scramble-robot/rcj-2022/Vison-raspi/cam-test/image/1.jpg

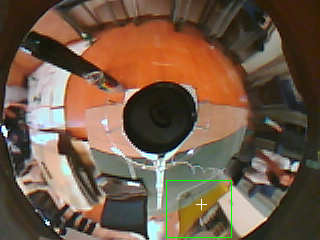
Vison-raspi/cam-test/image/1.jpg
