scramble-robot/rcj-2022/Vison-raspi/cam-test/image/2.jpg

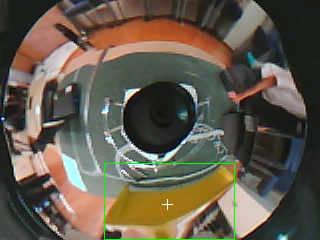
Vison-raspi/cam-test/image/2.jpg
