scramble-robot/rcj-2022/README.md

# rcj-2022

This program made by scramble rcj team.
