scramble-robot/rcj-2022/kicad/main-lg/main20220103/main20220103.dxf

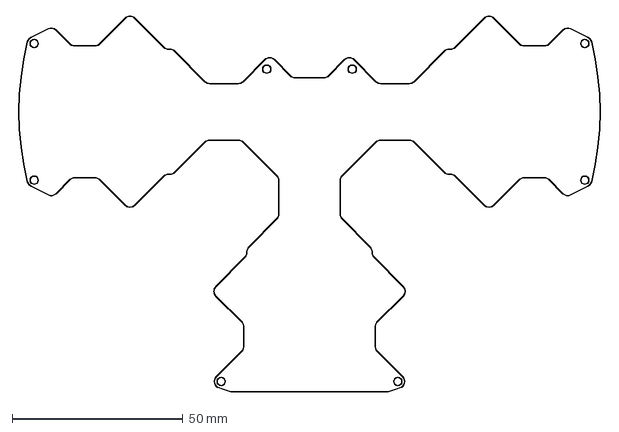
[picture p3: CAD file, 2022-02-06]
kicad/main-lg/main20220103/main20220103.dxf
171.7 x 109.9 mm
