scramble-robot/rcj-2022/kicad/kick-drib-2/control-2021-2.dxf

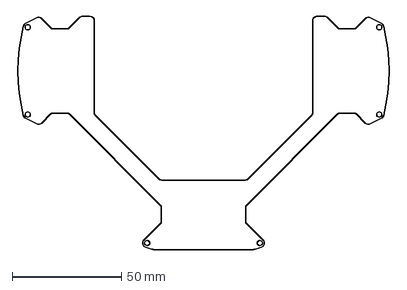
[picture p4: CAD file, 2022-02-06]
kicad/kick-drib-2/control-2021-2.dxf
171.7 x 106.9 mm
