scramble-robot/rcj-2022/kicad/line_senser20220225/line_senser20220224.step

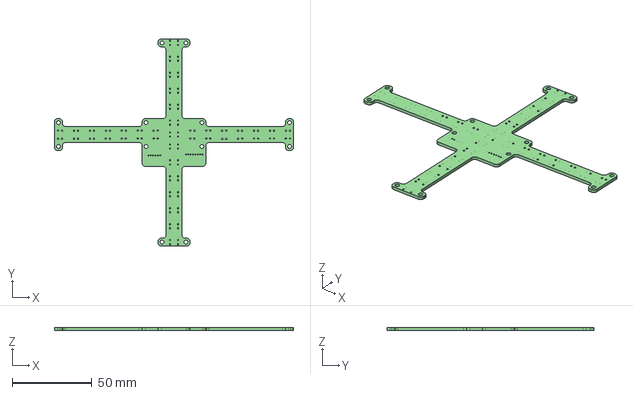
[picture p5: CAD file, 2022-02-26]
kicad/line_senser20220225/line_senser20220224.step
150.0 x 130.0 x 1.60 mm
