scramble-robot/rcj-2022/kicad/xbee-gyro20220207/xbee-gyro20220207.dxf

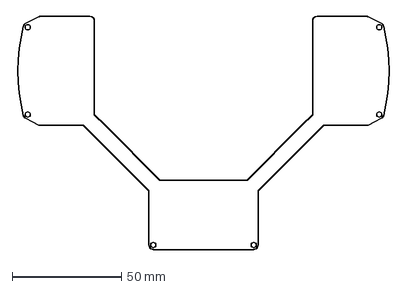
[picture p6: CAD file, 2022-02-06]
kicad/xbee-gyro20220207/xbee-gyro20220207.dxf
171.7 x 106.9 mm
