scramble-robot/rcj-2022/kicad/line_senser20220225/LINE!.dxf

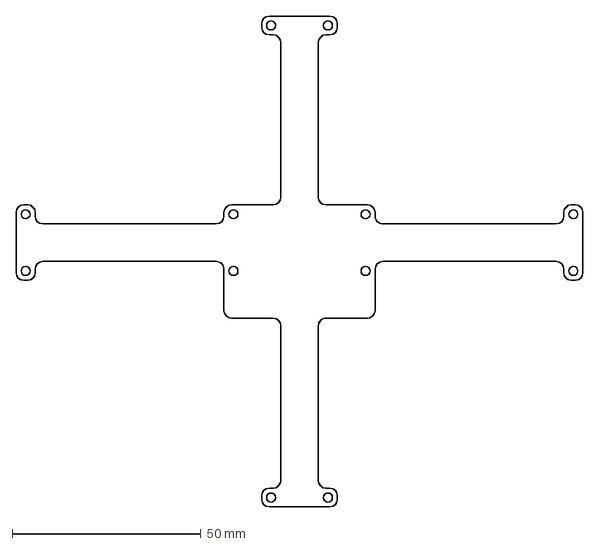
[picture p7: CAD file, 2022-02-26]
kicad/line_senser20220225/LINE!.dxf
150.0 x 130.0 mm
