scramble-robot/rcj-2022/kicad/line_senser20220225/line_senser20220225.step

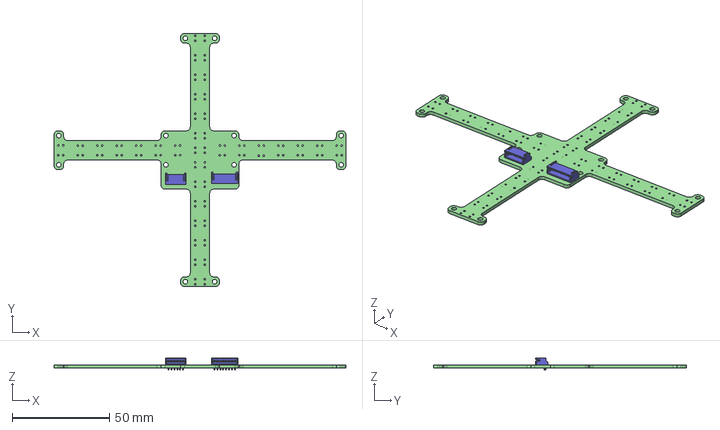
[picture p8: CAD file, 2022-02-26]
kicad/line_senser20220225/line_senser20220225.step
150.0 x 130.0 x 6.40 mm
line_senser20220224 PCB
