scramble-robot/rcj-2022/(list of files, cad)

Other CAD files:
kicad/line_senser20220225/line.dxf
kicad/line_senser20220225/line_senser20220225.dxf
