scramble-robot/rcj-2022/Vison-raspi/cam-test/colortracking-test/9.bmp

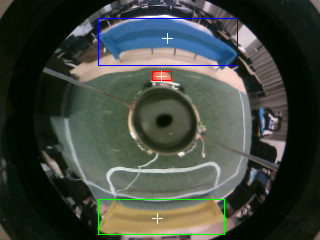
Vison-raspi/cam-test/colortracking-test/9.bmp
