scramble-robot/rcj-2022/Vison-raspi/cam-test/result.jpg

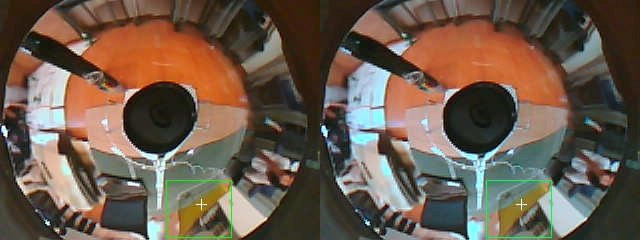
Vison-raspi/cam-test/result.jpg
