scramble-robot/rcj-2022/(list of files, drawings)

Other design files:
kicad/IMU_BNO055_20210802/IMU_BNO055_20210802.dsn
kicad/kick-drib-2/kick-drib-2.dsn
kicad/kick-drib/kick-drib.dsn
kicad/line_senser20220225/line_senser20220225.dsn
kicad/main20220221/main20220221.dsn
kicad/main-lg/main20220103/main20220103.dsn
kicad/main-lg/main20220212-2/main20220103-2.dsn
kicad/main-lg/main20220212-3/main20220212-3.dsn
kicad/main-lg/main20220213 - コピー/main20220213.dsn
kicad/main-lg/main20220213/main20220213.dsn
kicad/main-lg/main20220215/main20220215.dsn
kicad/main-lg/main20220217/main20220217.dsn
kicad/xbee-gyro20220207/xbee-gyro20220207.dsn
