scramble-robot/rcj-2022/kicad/xbee-gyro20220207/xbee-gyro20220207.kicad_pcb

## KiCad design kicad/xbee-gyro20220207/xbee-gyro20220207.kicad_pcb (2022-04-21)

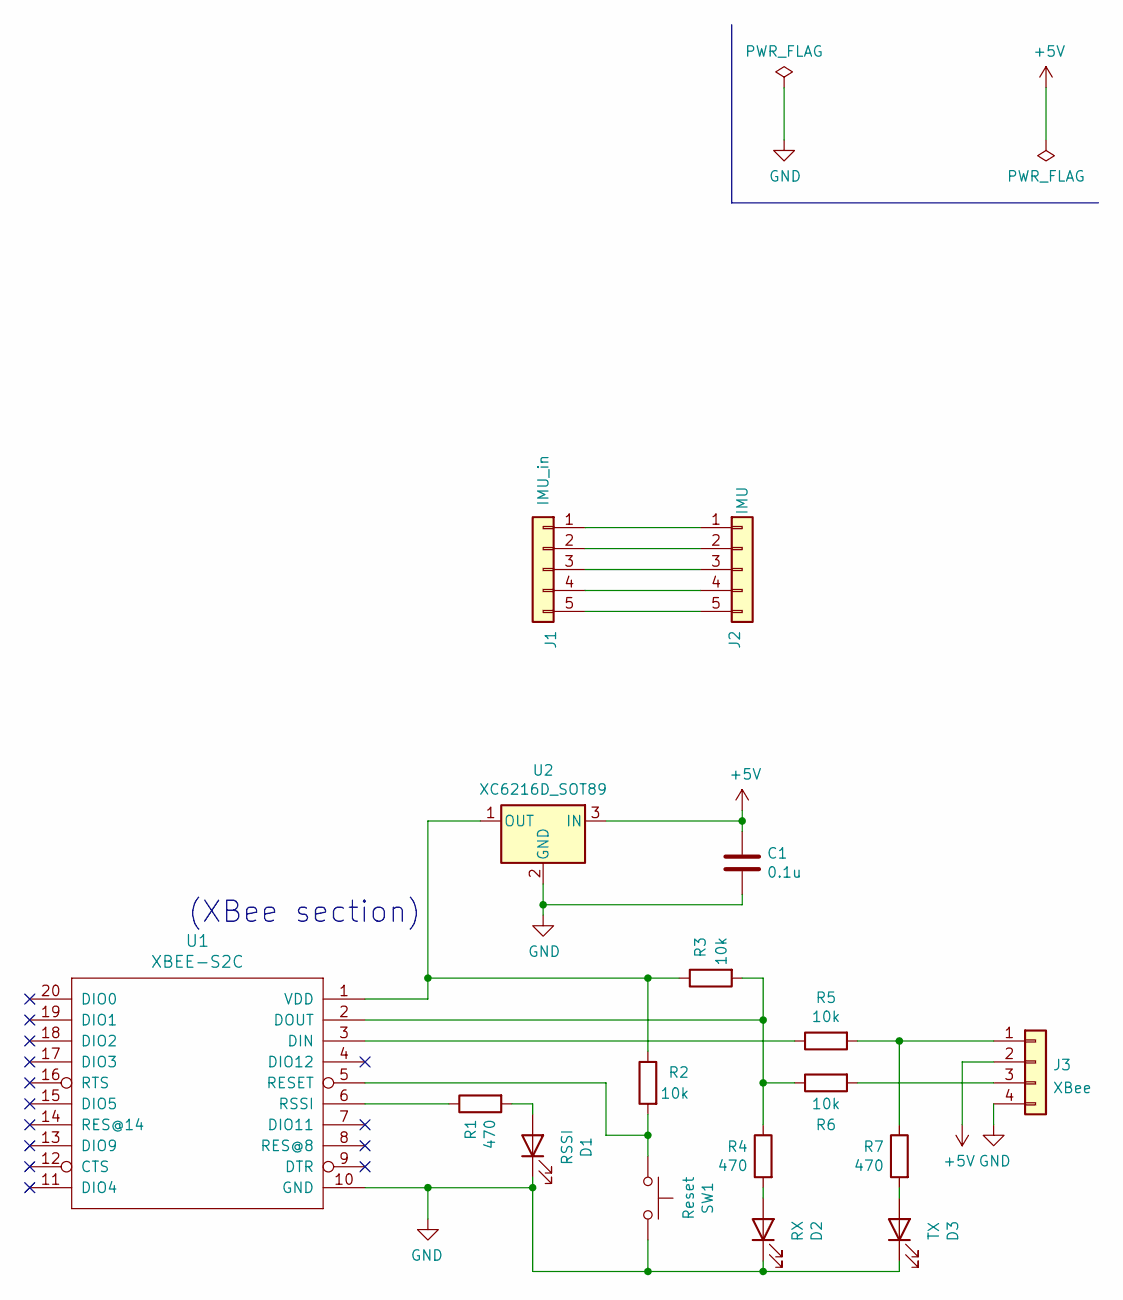
[picture p11: schematic xbee-gyro20220207.kicad_sch, control board]

Parts:
C1: 0.1u; C_0603_1608Metric_Pad1.08x0.95mm_HandSolder
D1: RSSI; LED_0603_1608Metric_Pad1.05x0.95mm_HandSolder
D2: RX; LED_0603_1608Metric_Pad1.05x0.95mm_HandSolder
D3: TX; LED_0603_1608Metric_Pad1.05x0.95mm_HandSolder
J1: IMU_in; PinHeader_1x05_P1.27mm_Vertical
J2: IMU; PinSocket_1x05_P2.54mm_Vertical
J3: XBee; PinSocket_1x04_P2.54mm_Vertical
R1, R4, R7: 470; R_0603_1608Metric_Pad0.98x0.95mm_HandSolder
R2, R3, R5, R6: 10k; R_0603_1608Metric_Pad0.98x0.95mm_HandSolder
SW1: Reset; THAU13-AB-R
U1: XBEE-S2C
U2: XC6216D_SOT89; SOT-89-3

Connections:
+5V: C1.1, J3.2, U2.3 (IN)
GND: C1.2, D1.1 (K), D2.1 (K), D3.1 (K), J3.4, SW1.2, U1.10 (GND), U2.2 (GND)
unnamed: D1.2 (A), R1.2
unnamed: D2.2 (A), R4.2
unnamed: D3.2 (A), R7.2
unnamed: J1.1, J2.1
unnamed: J1.2, J2.2
unnamed: J1.3, J2.3
unnamed: J1.4, J2.4
unnamed: J1.5, J2.5
unnamed: J3.1, R5.2, R7.1
unnamed: J3.3, R6.2
unnamed: R1.1, U1.6 (RSSI)
unnamed: R2.1, R3.1, U1.1 (VDD), U2.1 (OUT)
unnamed: R2.2, SW1.1, U1.5 (RESET)
unnamed: R3.2, R4.1, R6.1, U1.2 (DOUT)
unnamed: R5.1, U1.3 (DIN)

Notes on the sheet:
(XBee section)

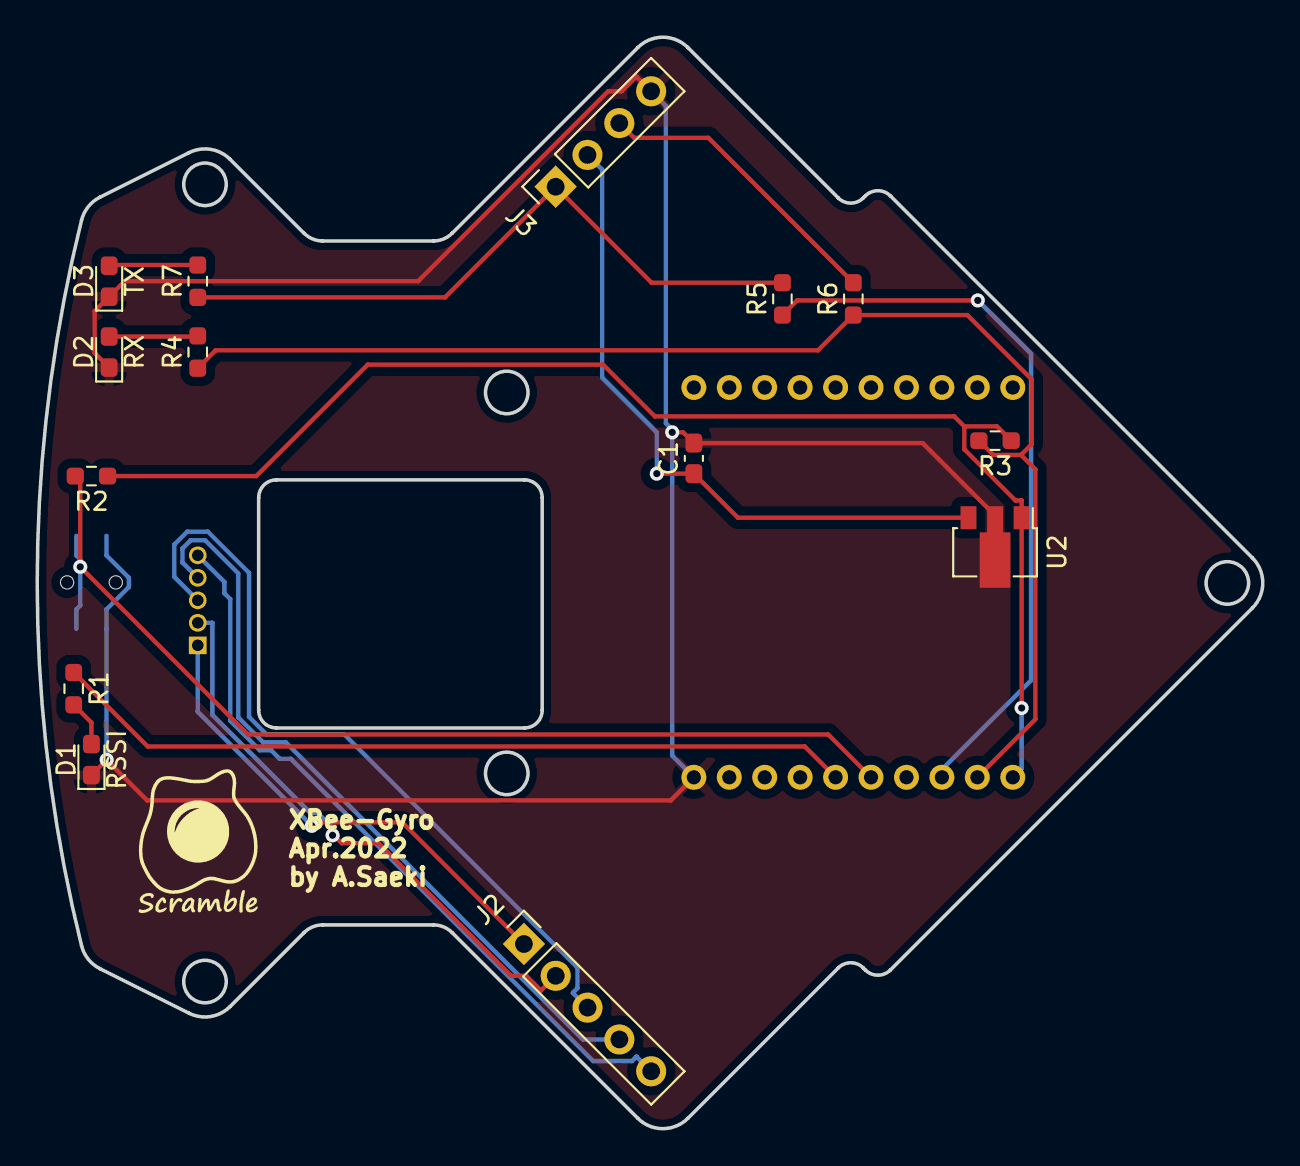
[picture p12: board xbee-gyro20220207.kicad_pcb from above]

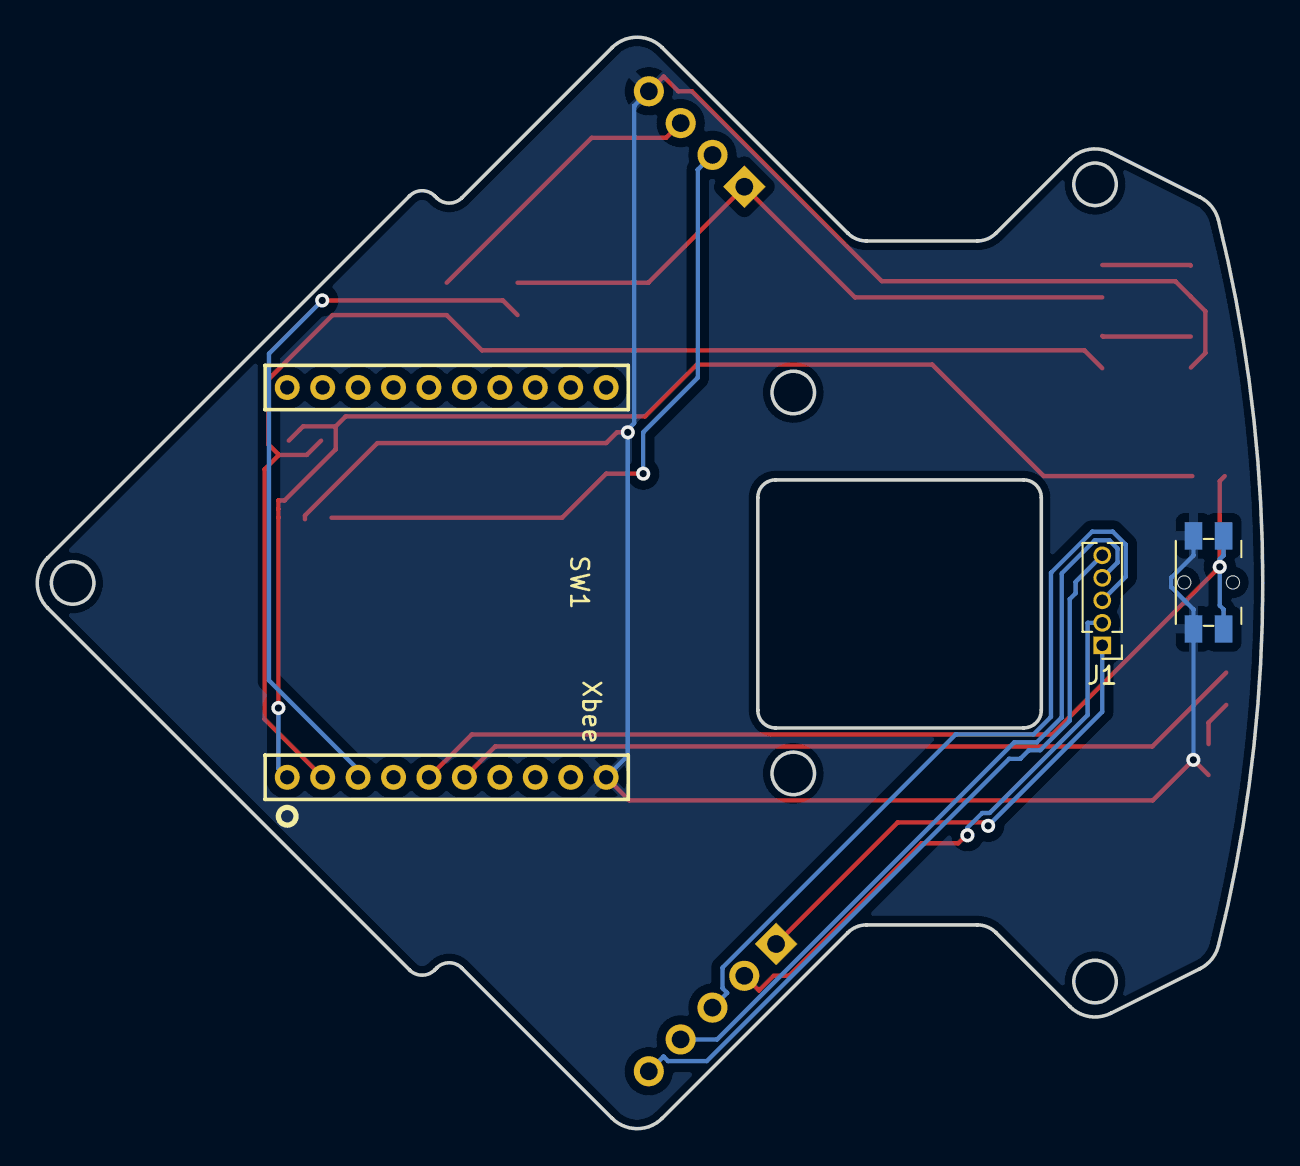
[picture p13: board xbee-gyro20220207.kicad_pcb from below]

Board: 2 copper layers, 69.2 x 61.6 mm, 17 parts (3 on the bottom side), 17 nets.
