scramble-robot/rcj-2022/kicad/main-lg/main20220217/main20220217.kicad_pcb

## KiCad design kicad/main-lg/main20220217/main20220217.kicad_pcb (2022-02-26)

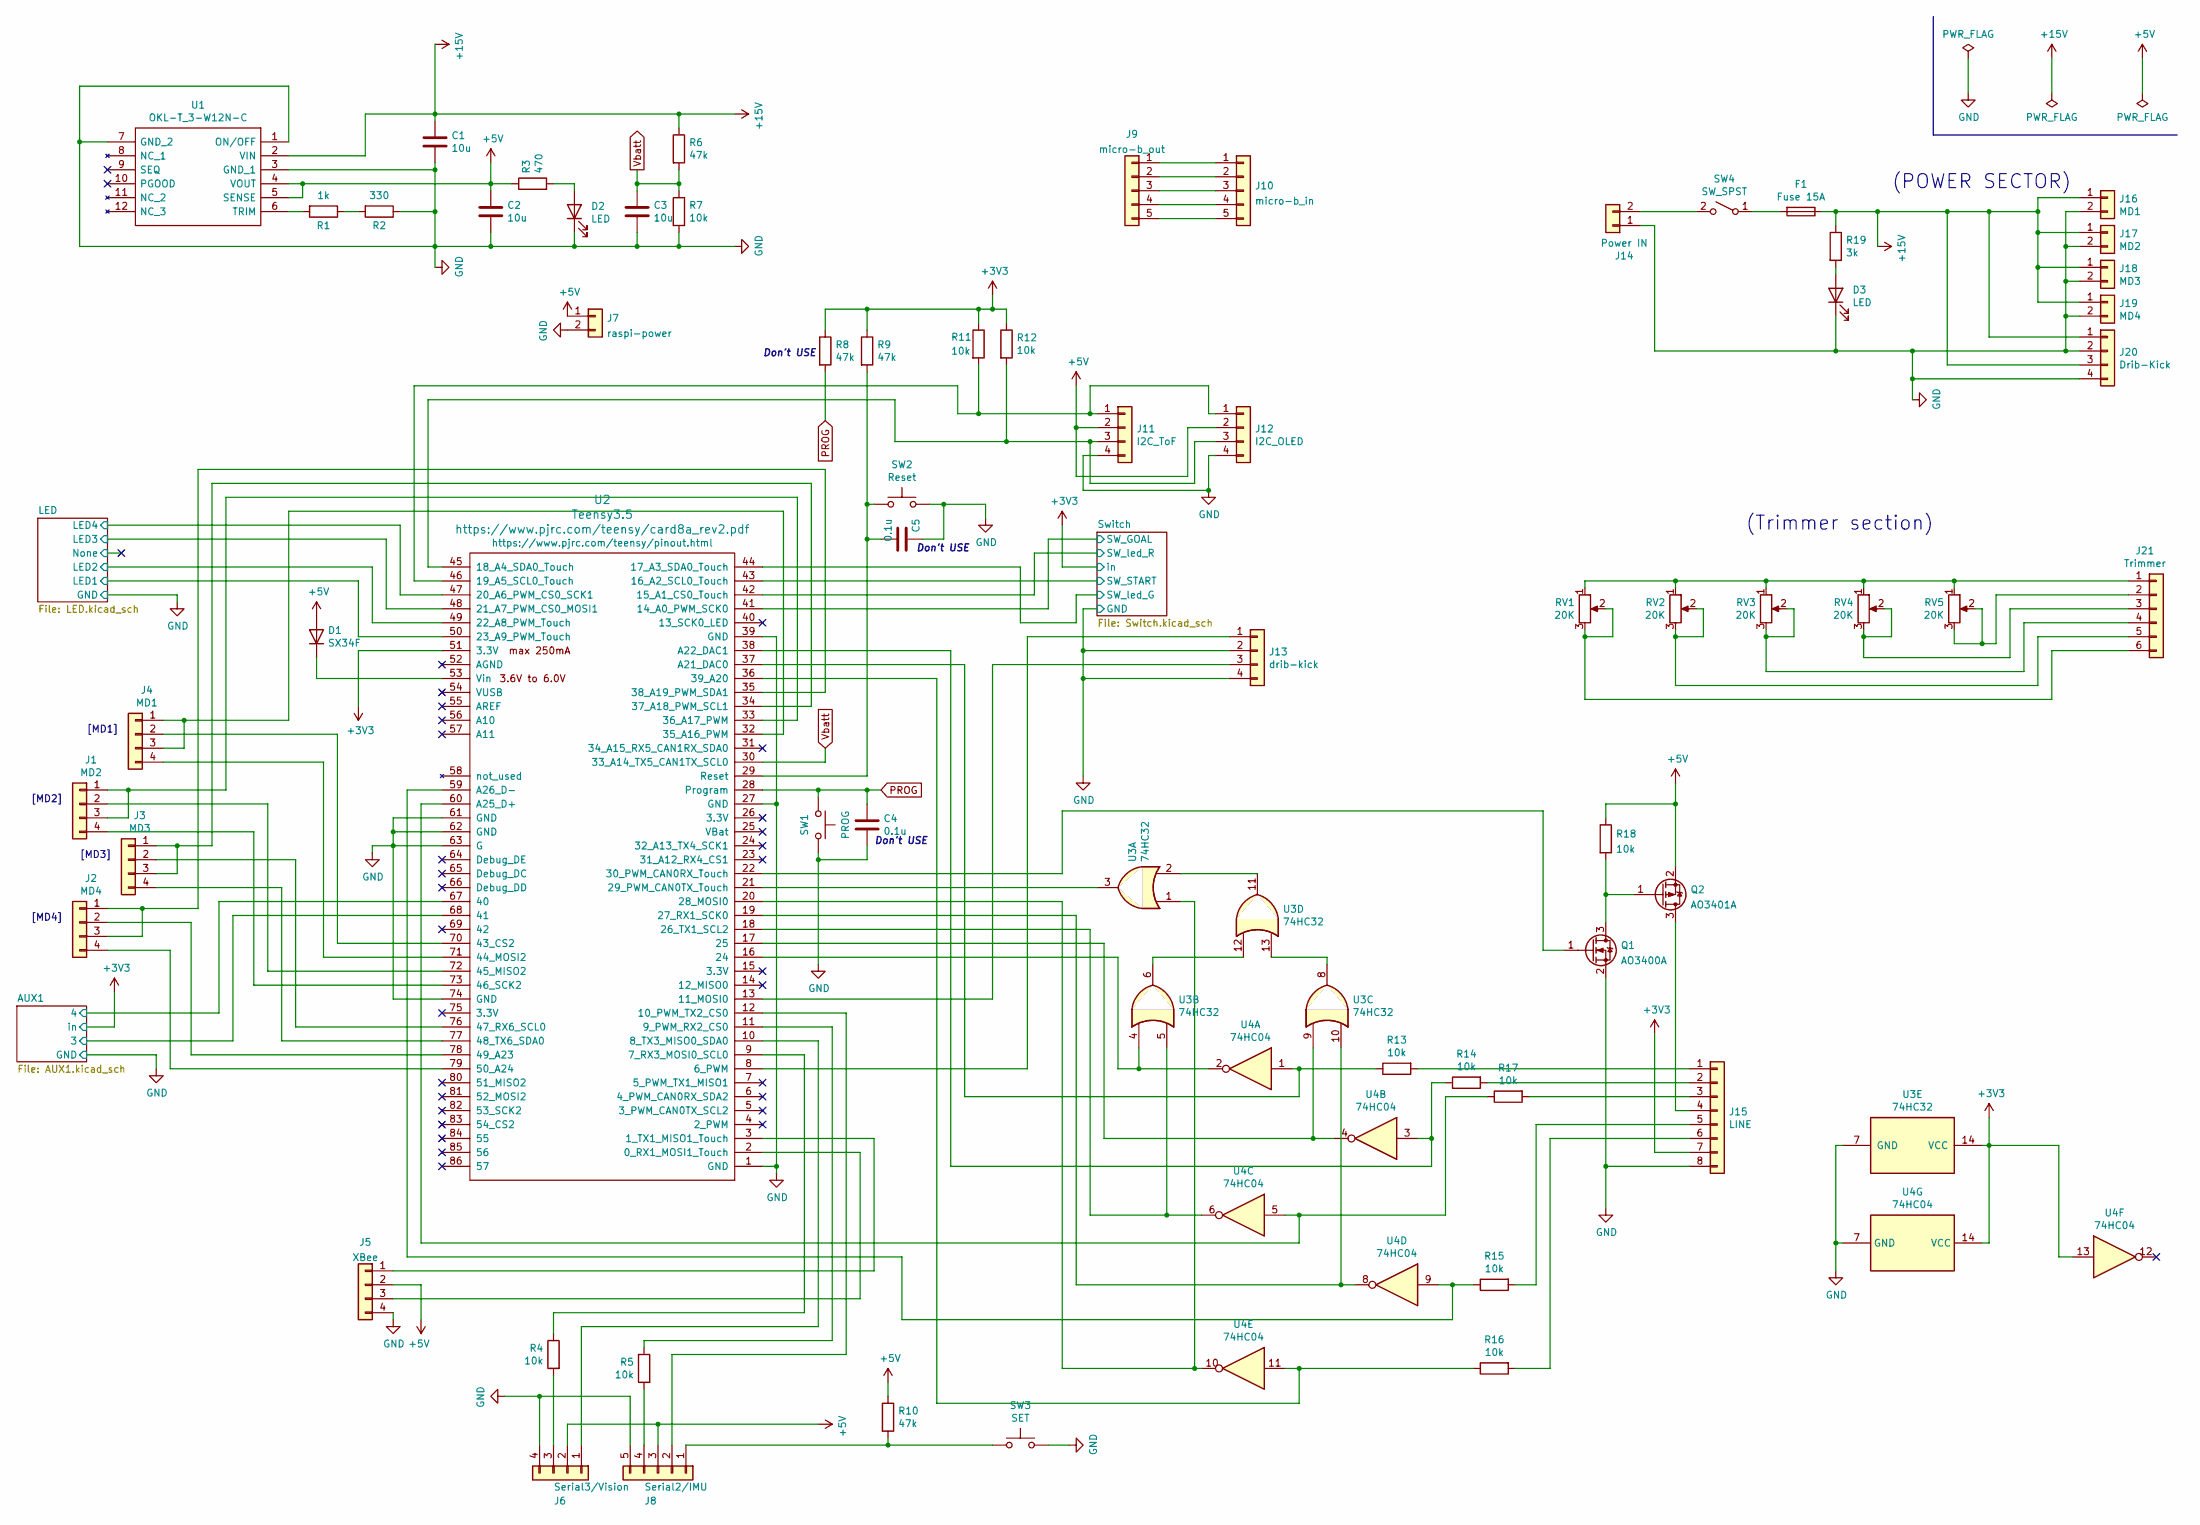
[picture p14: schematic main20220217.kicad_sch, main board]

Parts:
C1, C2, C3: 10u; C_0603_1608Metric_Pad1.08x0.95mm_HandSolder
C4, C5: 0.1u; C_0603_1608Metric_Pad1.08x0.95mm_HandSolder
D1: SX34F; D_SMA
D2, D3: LED; LED_SMLE13WBC8W1
F1: Fuse 15A; FUSE_20mm
J1: MD2; JSTS4B-ZRLFSN
J2: MD4; JSTS4B-ZRLFSN
J3: MD3; JSTS4B-ZRLFSN
J4: MD1; JSTS4B-ZRLFSN
J5: XBee; PinSocket_1x04_P2.54mm_Vertical
J6: Serial3/Vision; JSTB4B-ZR
J7: raspi-power; JST_PH_B2B-PH-K_1x02_P2.00mm_Vertical
J8: Serial2/IMU; PinSocket_1x05_P2.54mm_Vertical
J9: micro-b_out; PinHeader_1x05_P2.54mm_Vertical
J10: micro-b_in; PinHeader_1x05_P2.54mm_Vertical
J11: I2C_ToF; JSTS4B-ZRLFSN
J12: I2C_OLED; OLED
J13: drib-kick; PinSocket_1x04_P2.54mm_Vertical
J14: Power IN; AMASS_XT60-M_1x02_P7.20mm_Vertical
J15: LINE; JSTS8B-ZRLFSN
J16: MD1; JST_XH_B2B-XH-A_1x02_P2.50mm_Vertical
J17: MD2; JST_XH_B2B-XH-A_1x02_P2.50mm_Vertical
J18: MD3; JST_XH_B2B-XH-A_1x02_P2.50mm_Vertical
J19: MD4; JST_XH_B2B-XH-A_1x02_P2.50mm_Vertical
J20: Drib-Kick; PinSocket_1x04_P2.54mm_Vertical
J21: Trimmer; JSTS6B-ZRLFSN
Q1: AO3400A; SOT-23
Q2: AO3401A; SOT-23
R1: 1k; R_Axial_DIN0204_L3.6mm_D1.6mm_P5.08mm_Horizontal
R2: 330; R_Axial_DIN0204_L3.6mm_D1.6mm_P5.08mm_Horizontal
R3: 470; R_0603_1608Metric_Pad0.98x0.95mm_HandSolder
R4, R5, R7, R11, R12, R13, R14, R15, R16, R17, R18: 10k; R_0603_1608Metric_Pad0.98x0.95mm_HandSolder
R6, R8, R9, R10: 47k; R_0603_1608Metric_Pad0.98x0.95mm_HandSolder
R19: 3k; R_0603_1608Metric_Pad0.98x0.95mm_HandSolder
RV1, RV2, RV3, RV4, RV5: 20K; Trim-GF063P
SW1: PROG; TVAF06-A020B-R
SW2: Reset; THAU13-AB-R
SW3: SET; SW_PUSH_6mm
SW4: SW_SPST; SW_SPST_POWER
U1: OKL-T_3-W12N-C; OKL-T3-W12N-C; Manufacturer_Part_Number OKL-T/6-W12N-C; Mouser Part Number 580-OKL-T/6-W12N-C
U2: Teensy3.5; Teensy35_36_x
U3: 74HC32; SOP14W
U4: 74HC04; SOP14W

Connections:
+3V3: J15.7, R8.1, R9.1, R11.1, R12.1, U2.51 (3.3V), U3.14 (VCC), U4.13, U4.14 (VCC); also elsewhere on the board
+5V: C2.1, D1.2 (A), J5.2, J6.2, J7.1, J8.3, J11.2, J12.2, Q2.2 (S), R3.1, R10.1, R18.1, U1.4 (VOUT), U1.5 (SENSE)
/AUX1/3: U2.68 (41); also elsewhere on the board
/AUX1/4: U2.67 (40); also elsewhere on the board
/LED/LED1: U2.50 (23_A9_PWM_Touch); also elsewhere on the board
/LED/LED2: U2.49 (22_A8_PWM_Touch); also elsewhere on the board
/LED/LED3: U2.48 (21_A7_PWM_CS0_MOSI1); also elsewhere on the board
/LED/LED4: U2.47 (20_A6_PWM_CS0_SCK1); also elsewhere on the board
/Switch/SW_GOAL: U2.41 (14_A0_PWM_SCK0); also elsewhere on the board
/Switch/SW_START: U2.43 (16_A2_SCL0_Touch); also elsewhere on the board
/Switch/SW_led_G: U2.44 (17_A3_SDA0_Touch); also elsewhere on the board
/Switch/SW_led_R: U2.42 (15_A1_CS0_Touch); also elsewhere on the board
unnamed: C5.2, R9.2, SW2.1, U2.29 (Reset)
unnamed: D1.1 (K), U2.53 (Vin)
unnamed: D2.2 (A), R3.2
unnamed: D3.2 (A), R19.2
unnamed: F1.2, SW4.1 (A)
unnamed: J1.1, J1.3, U2.33 (36_A17_PWM)
unnamed: J1.2, U2.72 (45_MISO2)
unnamed: J1.4, U2.73 (46_SCK2)
unnamed: J2.1, J2.3, U2.35 (38_A19_PWM_SDA1)
unnamed: J2.2, U2.78 (49_A23)
unnamed: J2.4, U2.79 (50_A24)
unnamed: J3.1, J3.3, U2.34 (37_A18_PWM_SCL1)
unnamed: J3.2, U2.76 (47_RX6_SCL0)
unnamed: J3.4, U2.77 (48_TX6_SDA0)
unnamed: J4.1, J4.3, U2.32 (35_A16_PWM)
unnamed: J4.2, U2.70 (43_CS2)
unnamed: J4.4, U2.71 (44_MOSI2)
unnamed: J5.1, U2.3 (1_TX1_MISO1_Touch)
unnamed: J5.3, U2.2 (0_RX1_MOSI1_Touch)
unnamed: J6.1, U2.10 (8_TX3_MISO0_SDA0)
unnamed: J6.3, R4.2
unnamed: J8.1, R10.2, SW3.1
unnamed: J8.2, U2.12 (10_PWM_TX2_CS0)
unnamed: J8.4, R5.2
unnamed: J9.1, J10.1
unnamed: J9.2, J10.2
unnamed: J9.3, J10.3
unnamed: J9.4, J10.4
unnamed: J9.5, J10.5
unnamed: J11.1, J12.1, R11.2, U2.46 (19_A5_SCL0_Touch)
unnamed: J11.3, J12.3, R12.2, U2.45 (18_A4_SDA0_Touch)
unnamed: J13.1, U2.8 (6_PWM)
unnamed: J13.3, U2.13 (11_MOSI0)
unnamed: J14.2, SW4.2 (B)
unnamed: J15.1, R13.2
unnamed: J15.2, R14.2
unnamed: J15.3, R17.2
unnamed: J15.4, Q2.3 (D)
unnamed: J15.5, R15.2
unnamed: J15.6, R16.2
unnamed: J21.1, RV1.1, RV2.1, RV3.1, RV4.1, RV5.1
unnamed: J21.2, RV5.2, RV5.3
unnamed: J21.3, RV4.2, RV4.3
unnamed: J21.4, RV3.2, RV3.3
unnamed: J21.5, RV2.2, RV2.3
unnamed: J21.6, RV1.2, RV1.3
unnamed: Q1.3 (D), Q2.1 (G), R18.2
unnamed: R1.1, R2.2
unnamed: R1.2, U1.6 (TRIM)
unnamed: R4.1, U2.9 (7_RX3_MOSI0_SCL0)
unnamed: R5.1, U2.11 (9_PWM_RX2_CS0)
unnamed: R13.1, U2.37 (A21_DAC0), U4.1
unnamed: R14.1, U2.38 (A22_DAC1), U4.3
unnamed: R15.1, U2.59 (A26_D-), U4.9
unnamed: R16.1, U2.36 (39_A20), U4.11
unnamed: R17.1, U2.60 (A25_D+), U4.5
unnamed: U2.16 (24), U3.4, U4.2
unnamed: U2.17 (25), U3.9, U4.4
unnamed: U2.18 (26_TX1_SCL2), U3.5, U4.6
unnamed: U2.19 (27_RX1_SCK0), U3.10, U4.8
unnamed: U2.20 (28_MOSI0), U3.1, U4.10
unnamed: U2.21 (29_PWM_CAN0TX_Touch), U3.3
unnamed: U3.2, U3.11
unnamed: U3.6, U3.12
unnamed: U3.8, U3.13
PROG: C4.1, R8.2, SW1.1, U2.28 (Program)
Vbatt: C3.1, R6.2, R7.1, U2.30 (33_A14_TX5_CAN1TX_SCL0)

Notes on the sheet:
(POWER SECTOR)
(Trimmer section)
Don't USE
[MD3]
[MD2]
[MD1]
[MD4]

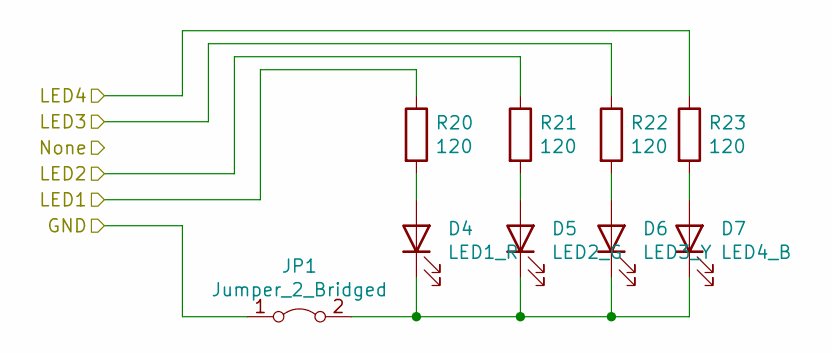
[picture p15: schematic LED.kicad_sch]

Parts:
D4: LED1_R; LED_SMLE13WBC8W1
D5: LED2_G; LED_SMLE13WBC8W1
D6: LED3_Y; LED_SMLE13WBC8W1
D7: LED4_B; LED_SMLE13WBC8W1
JP1: Jumper_2_Bridged; PinHeader_1x02_P1.27mm_Vertical
R20, R21, R22, R23: 120; R_0603_1608Metric_Pad0.98x0.95mm_HandSolder

Connections:
/LED/LED1: R20.1; also elsewhere on the board
/LED/LED2: R21.1; also elsewhere on the board
/LED/LED3: R22.1; also elsewhere on the board
/LED/LED4: R23.1; also elsewhere on the board
unnamed: D4.1 (K), D5.1 (K), D6.1 (K), D7.1 (K), JP1.2 (B)
unnamed: D4.2 (A), R20.2
unnamed: D5.2 (A), R21.2
unnamed: D6.2 (A), R22.2
unnamed: D7.2 (A), R23.2

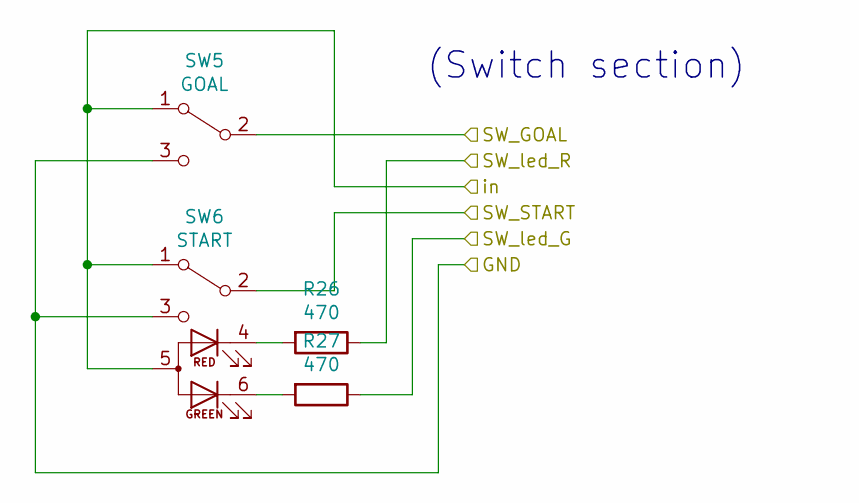
[picture p16: schematic Switch.kicad_sch]

Parts:
R26, R27: 470; R_0603_1608Metric_Pad0.98x0.95mm_HandSolder
SW5: GOAL; MFS101D-14-Z
SW6: START; SW_NKK_B-12CCPRM

Connections:
+3V3: SW5.1 (A), SW6.1 (A), SW6.5 (A); also elsewhere on the board
/Switch/SW_GOAL: SW5.2 (B); also elsewhere on the board
/Switch/SW_START: SW6.2 (B); also elsewhere on the board
/Switch/SW_led_G: R27.1; also elsewhere on the board
/Switch/SW_led_R: R26.1; also elsewhere on the board
unnamed: R26.2, SW6.4 (KR)
unnamed: R27.2, SW6.6 (KG)

Notes on the sheet:
(Switch section)

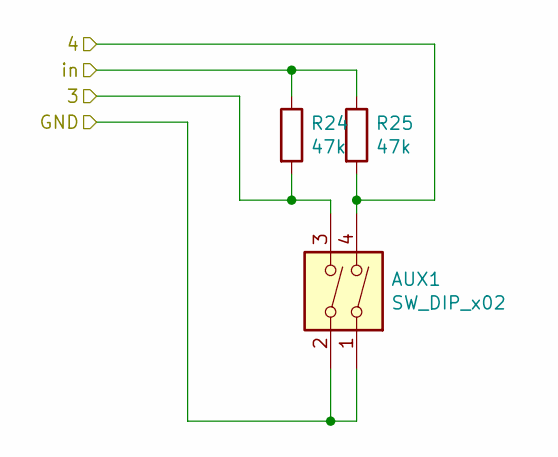
[picture p17: schematic AUX1.kicad_sch]

Parts:
AUX1: SW_DIP_x02; SW_DIP_SPSTx02_Slide_9.78x7.26mm_W7.62mm_P2.54mm
R24, R25: 47k; R_0603_1608Metric_Pad0.98x0.95mm_HandSolder

Connections:
+3V3: R24.1, R25.1; also elsewhere on the board
/AUX1/3: AUX1.3, R24.2; also elsewhere on the board
/AUX1/4: AUX1.4, R25.2; also elsewhere on the board

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
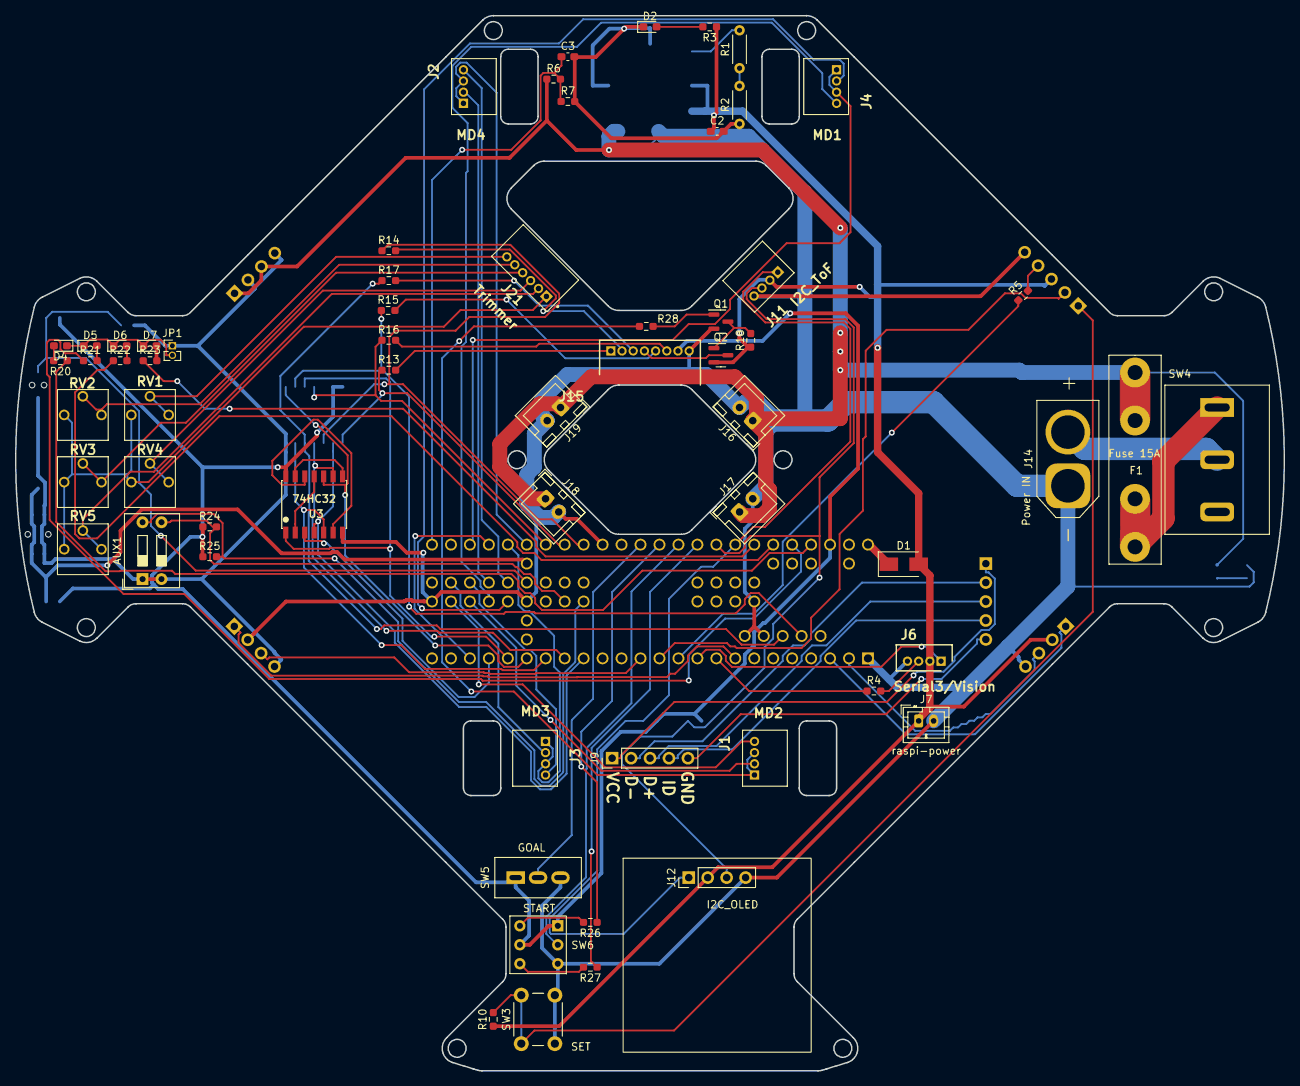
[picture p18: board main20220217.kicad_pcb from above]

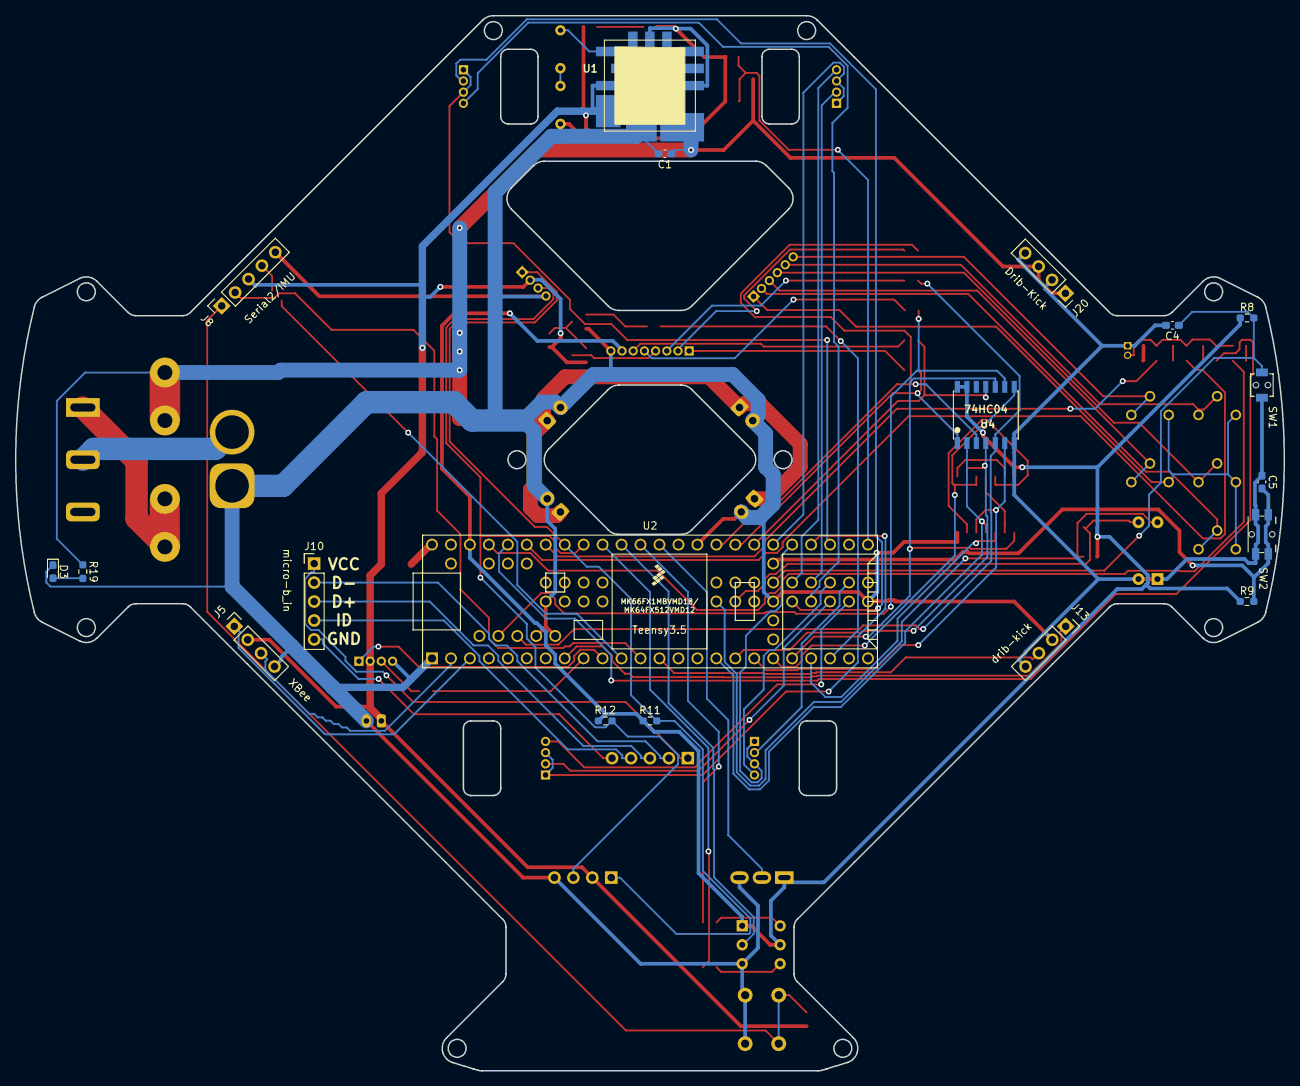
[picture p19: board main20220217.kicad_pcb from below]

Board: 2 copper layers, 170.0 x 141.4 mm, 81 parts (19 on the bottom side), 90 nets.

Other parts of the board:
R28: 120; R_0603_1608Metric_Pad0.98x0.95mm_HandSolder
