scramble-robot/rcj-2022/kicad/line_senser20220225/line_senser20220225.kicad_pcb

## KiCad design kicad/line_senser20220225/line_senser20220225.kicad_pcb (2022-02-26)

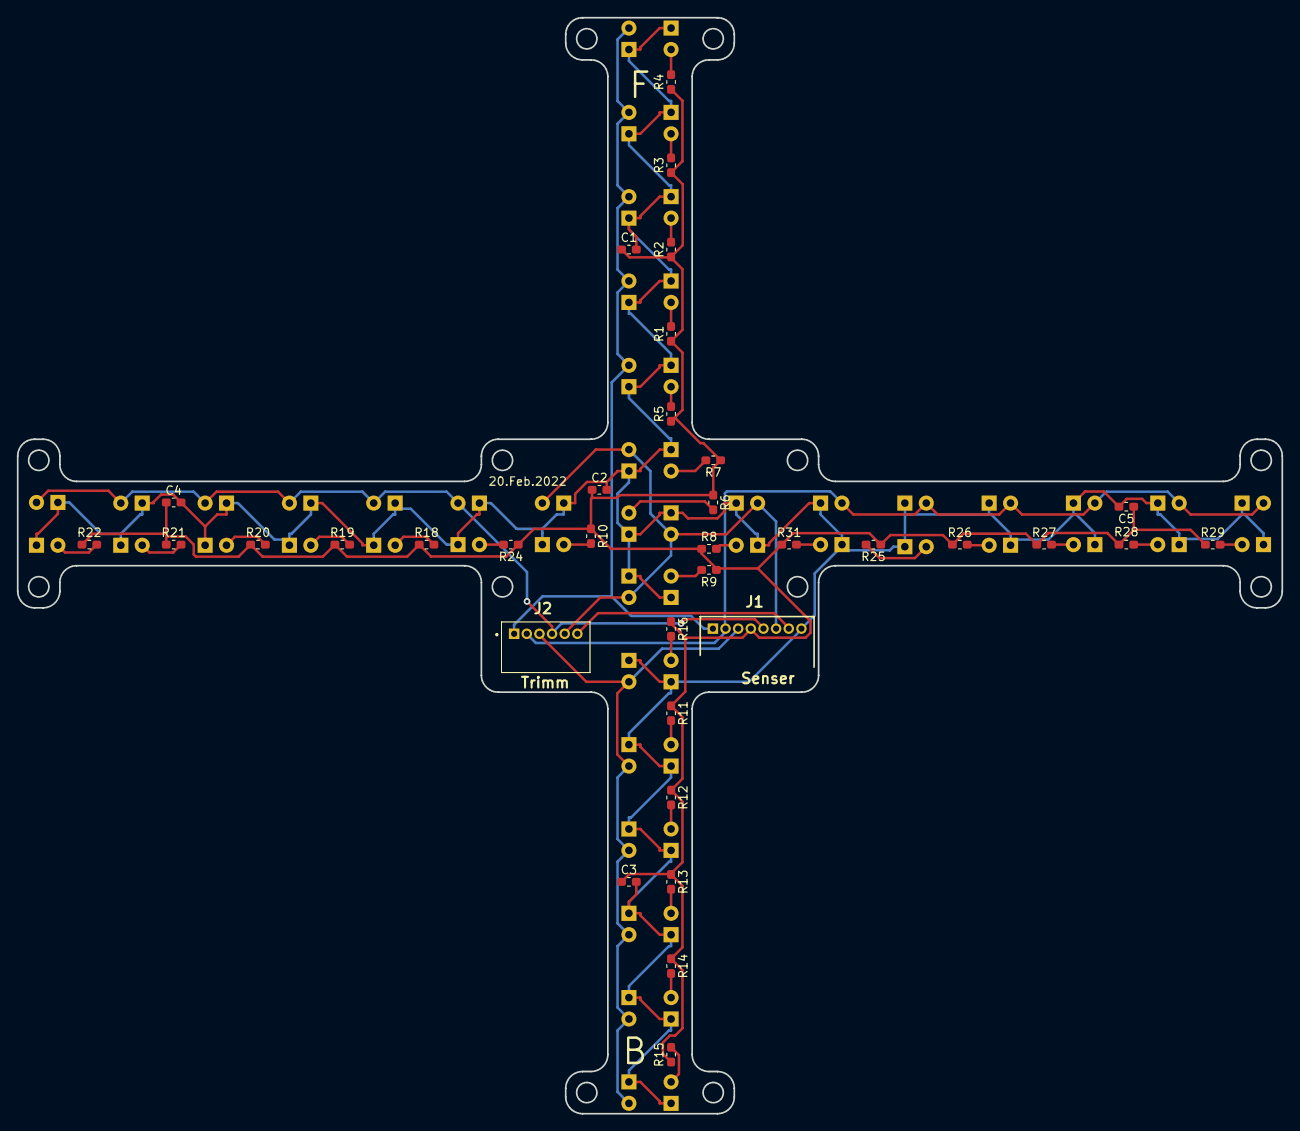
[picture p20: board line_senser20220225.kicad_pcb from above]

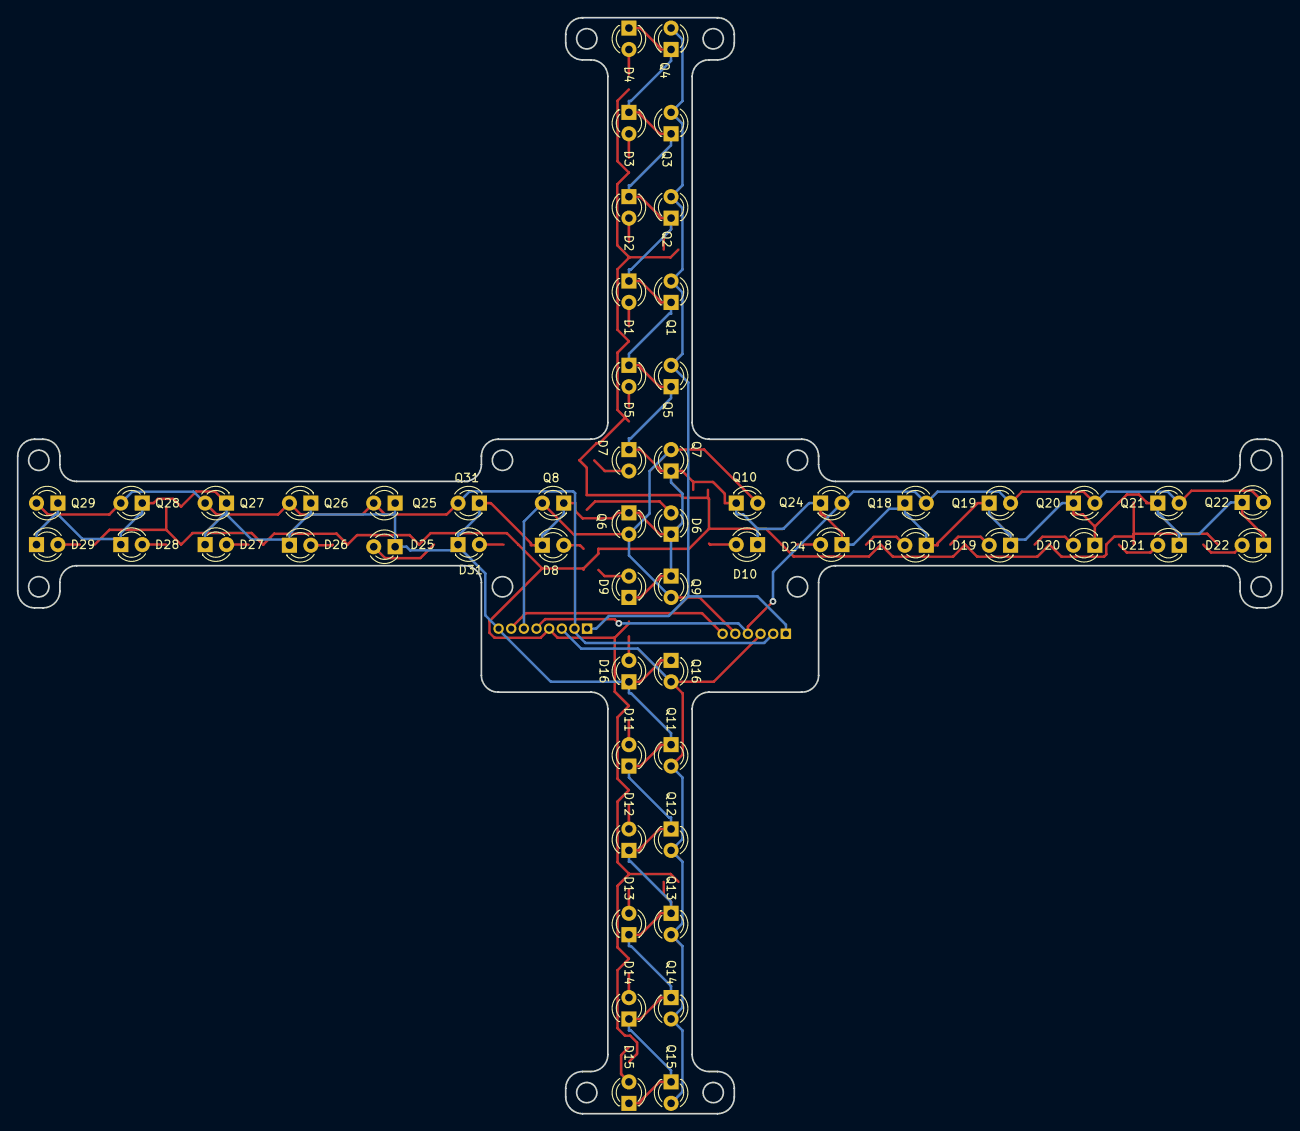
[picture p21: board line_senser20220225.kicad_pcb from below]

Board: 2 copper layers, 150.0 x 130.0 mm, 91 parts (56 on the bottom side), 36 nets.

Parts:
C1, C2, C3, C4, C5: 10u; C_0603_1608Metric_Pad1.05x0.95mm_HandSolder
D1, D2, D3, D4, D5, D6, D7, D8, D9, D10, D11, D12, D13, D14, D15, D16, D18, D19, D20, D21, D22, D24, D25, D26, D27, D28, D29, D31: LED; OSW54K3131A
J1: Senser; JSTS8B-ZRLFSN
J2: Trimm; JSTS6B-ZRLFSN
Q1, Q2, Q3, Q4, Q5, Q6, Q7, Q8, Q9, Q10, Q11, Q12, Q13, Q14, Q15, Q16, Q18, Q19, Q20, Q21, Q22, Q24, Q25, Q26, Q27, Q28, Q29, Q31: Q_Photo; NJL7502L
R1, R2, R3, R4, R5, R6, R7, R8, R9, R10, R11, R12, R13, R14, R15, R16, R18, R19, R20, R21, R22, R24, R25, R26, R27, R28, R29, R31: 470; R_0603_1608Metric_Pad1.05x0.95mm_HandSolder

Connections:
unnamed: C1.1, C2.1, C3.1, C4.1, C5.1, J1.4, R1.1, R2.1, R3.1, R4.1, R5.1, R6.1, R7.1, R8.1, R9.1, R10.1, R11.1, R12.1, R13.1, R14.1, R15.1, R16.1, R18.1, R19.1, R20.1, R21.1, R22.1, R24.1, R25.1, R26.1, R27.1, R28.1, R29.1, R31.1
unnamed: C1.2, C2.2, C3.2, C4.2, C5.2, D1.1 (K), D2.1 (K), D3.1 (K), D4.1 (K), D5.1 (K), D6.1 (K), D7.1 (K), D8.1 (K), D9.1 (K), D10.1 (K), D11.1 (K), D12.1 (K), D13.1 (K), D14.1 (K), D15.1 (K), D16.1 (K), D18.1 (K), D19.1 (K), D20.1 (K), D21.1 (K), D22.1 (K), D24.1 (K), D25.1 (K), D26.1 (K), D27.1 (K), D28.1 (K), D29.1 (K), D31.1 (K), J1.8, Q1.1 (E), Q2.1 (E), Q3.1 (E), Q4.1 (E), Q5.1 (E), Q6.1 (E), Q7.1 (E), Q8.1 (E), Q9.1 (E), Q10.1 (E), Q11.1 (E), Q12.1 (E), Q13.1 (E), Q14.1 (E), Q15.1 (E), Q16.1 (E), Q18.1 (E), Q19.1 (E), Q20.1 (E), Q21.1 (E), Q22.1 (E), Q24.1 (E), Q25.1 (E), Q26.1 (E), Q27.1 (E), Q28.1 (E), Q29.1 (E), Q31.1 (E)
unnamed: D1.2 (A), R1.2
unnamed: D2.2 (A), R2.2
unnamed: D3.2 (A), R3.2
unnamed: D4.2 (A), R4.2
unnamed: D5.2 (A), R5.2
unnamed: D6.2 (A), R6.2
unnamed: D7.2 (A), R7.2
unnamed: D8.2 (A), R8.2
unnamed: D9.2 (A), R9.2
unnamed: D10.2 (A), R10.2
unnamed: D11.2 (A), R11.2
unnamed: D12.2 (A), R12.2
unnamed: D13.2 (A), R13.2
unnamed: D14.2 (A), R14.2
unnamed: D15.2 (A), R15.2
unnamed: D16.2 (A), R16.2
unnamed: D18.2 (A), R18.2
unnamed: D19.2 (A), R19.2
unnamed: D20.2 (A), R20.2
unnamed: D21.2 (A), R21.2
unnamed: D22.2 (A), R22.2
unnamed: D24.2 (A), R24.2
unnamed: D25.2 (A), R25.2
unnamed: D26.2 (A), R26.2
unnamed: D27.2 (A), R27.2
unnamed: D28.2 (A), R28.2
unnamed: D29.2 (A), R29.2
unnamed: D31.2 (A), R31.2
unnamed: J1.1, J2.1, Q1.2 (C), Q2.2 (C), Q3.2 (C), Q4.2 (C), Q5.2 (C)
unnamed: J1.2, J2.2, Q25.2 (C), Q26.2 (C), Q27.2 (C), Q28.2 (C), Q29.2 (C), Q31.2 (C)
unnamed: J1.3, J2.3, Q11.2 (C), Q12.2 (C), Q13.2 (C), Q14.2 (C), Q15.2 (C), Q16.2 (C)
unnamed: J1.5, J2.4, Q18.2 (C), Q19.2 (C), Q20.2 (C), Q21.2 (C), Q22.2 (C), Q24.2 (C)
unnamed: J1.6, J2.5, Q6.2 (C), Q7.2 (C), Q8.2 (C), Q9.2 (C), Q10.2 (C)
unnamed: J1.7, J2.6
