scramble-robot/rcj-2022/kicad/kick-drib-2/kick-drib-2.kicad_pcb

## KiCad design kicad/kick-drib-2/kick-drib-2.kicad_pcb (2022-02-26)

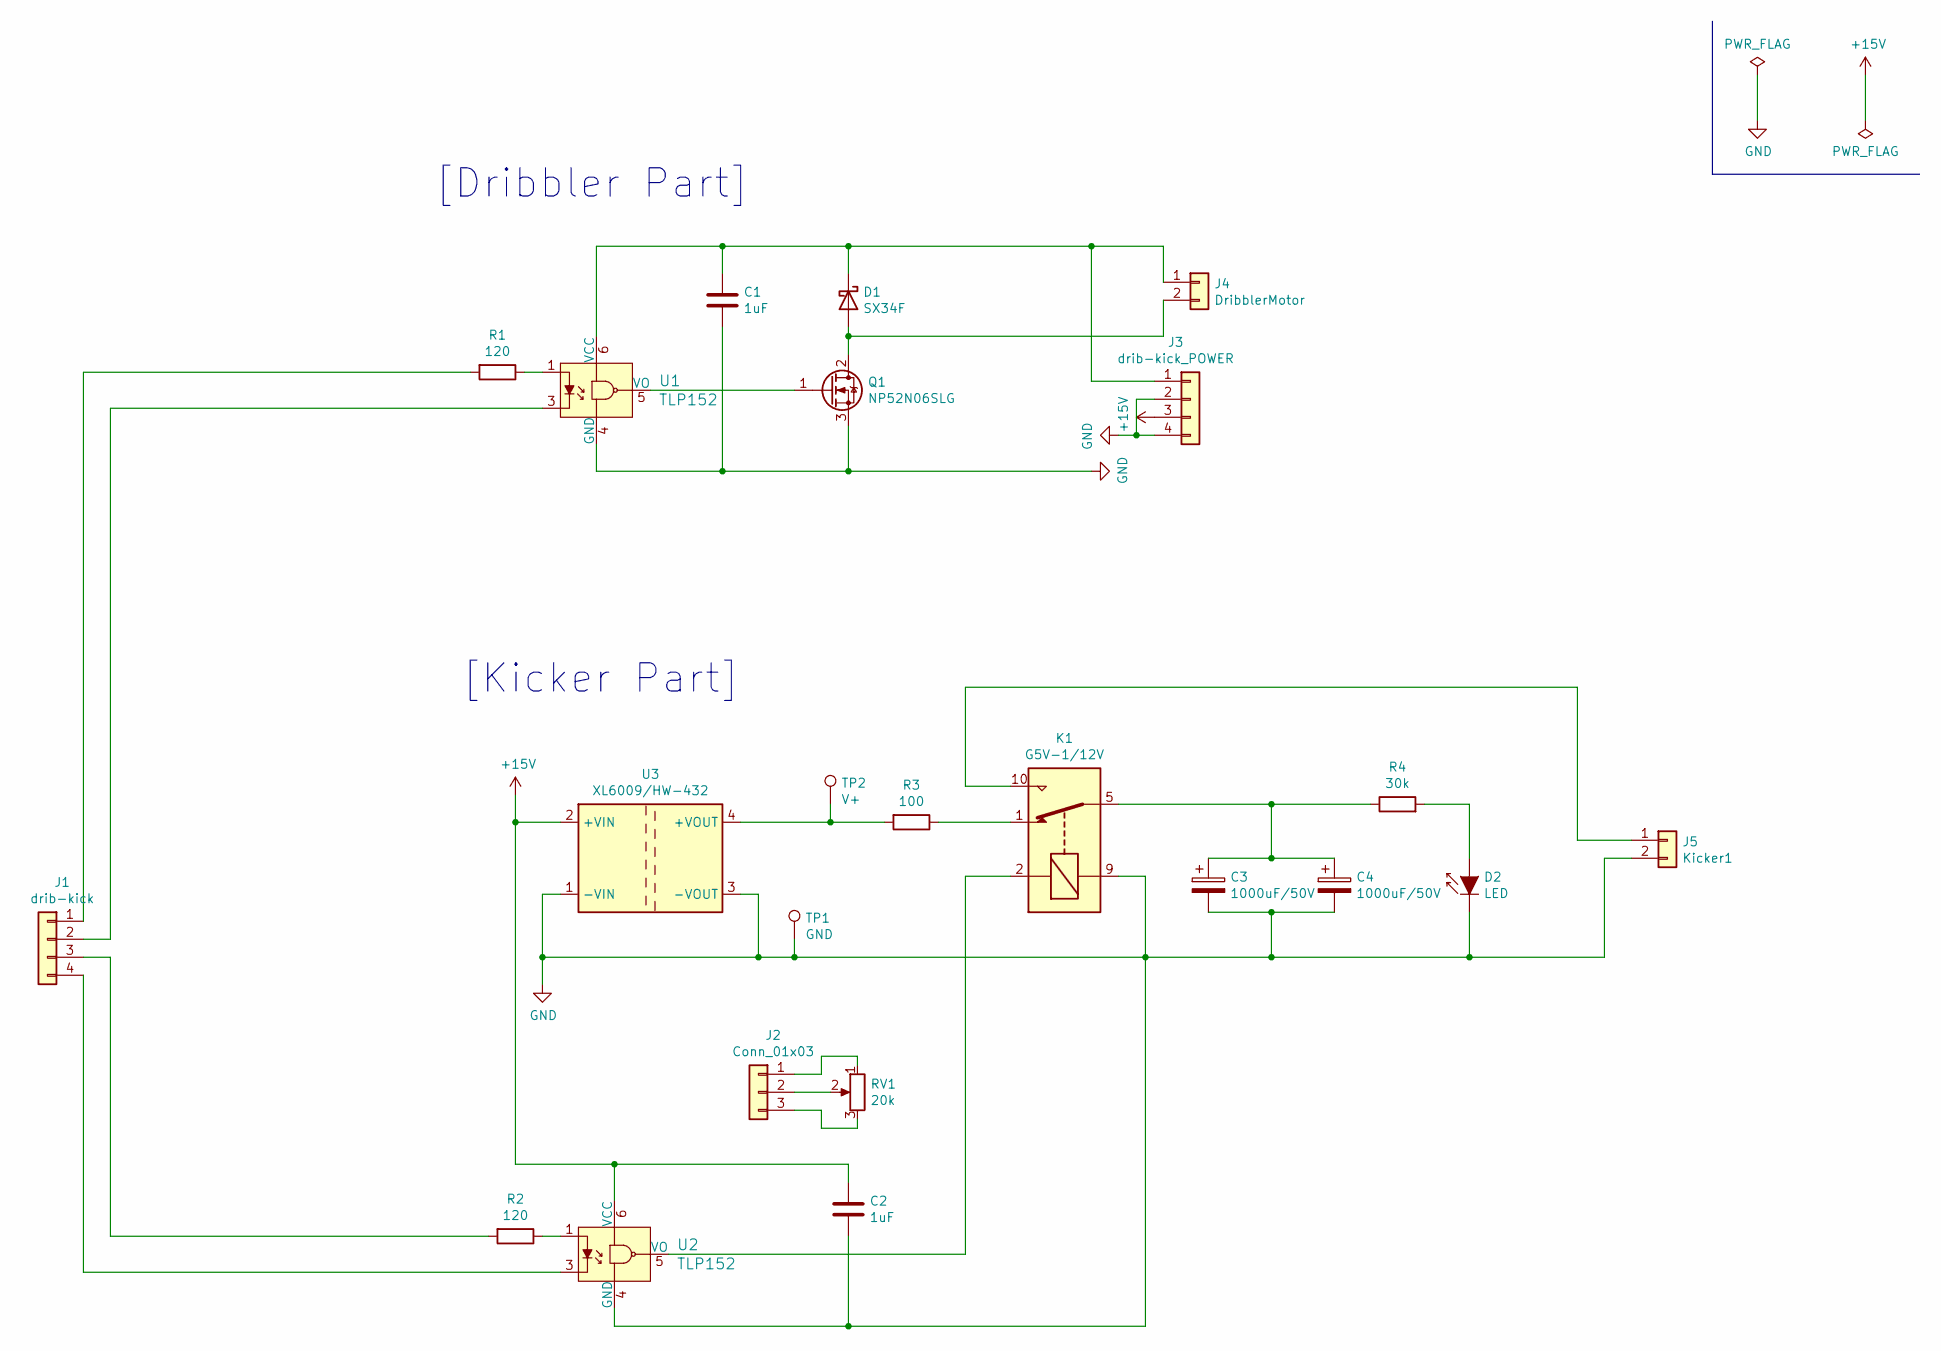
[picture p22: schematic kick-drib-2.kicad_sch, control board]

Parts:
C1, C2: 1uF; C_0603_1608Metric_Pad1.08x0.95mm_HandSolder
C3, C4: 1000uF/50V; CP_Radial_D12.5mm_P7.50mm
D1: SX34F; D_SMA
D2: LED; LED_0603_1608Metric_Pad1.05x0.95mm_HandSolder
J1: drib-kick; PinHeader_1x04_P2.54mm_Vertical
J2: Conn_01x03; PinHeader_1x03_P2.54mm_Vertical
J3: drib-kick_POWER; PinHeader_1x04_P2.54mm_Vertical
J4: DribblerMotor; JST_XH_B2B-XH-A_1x02_P2.50mm_Vertical
J5: Kicker1; JST_XH_B2B-XH-A_1x02_P2.50mm_Vertical
K1: G5V-1/12V; Relay_SPDT_Omron_G5V-1
Q1: NP52N06SLG; TO-252-2
R1, R2: 120; R_0603_1608Metric_Pad0.98x0.95mm_HandSolder
R3: 100; R_Axial_DIN0411_L9.9mm_D3.6mm_P20.32mm_Horizontal
R4: 30k; R_Axial_DIN0204_L3.6mm_D1.6mm_P5.08mm_Horizontal
RV1: 20k; Trim-GF063X
TP1: GND; TestPoint_Loop_D2.60mm_Drill0.9mm_Beaded
TP2: V+; TestPoint_Loop_D2.60mm_Drill0.9mm_Beaded
U1, U2: TLP152
U3: XL6009/HW-432; XL6009_HW432

Connections:
+15V: C2.1, J3.3, U2.6 (VCC), U3.2 (+VIN)
GND: C1.2, C2.2, C3.2, C4.2, D2.1 (K), J3.2, J3.4, J5.2, K1.9, Q1.3 (S), TP1.1, U1.4 (GND), U2.4 (GND), U3.1 (-VIN), U3.3 (-VOUT)
unnamed: C1.1, D1.1 (K), J3.1, J4.1, U1.6 (VCC)
unnamed: C3.1, C4.1, K1.5, K1.6, R4.1
unnamed: D1.2 (A), J4.2, Q1.2 (D)
unnamed: D2.2 (A), R4.2
unnamed: J1.1, R1.2
unnamed: J1.2, U1.3
unnamed: J1.3, R2.2
unnamed: J1.4, U2.3
unnamed: J2.1, RV1.1
unnamed: J2.2, RV1.2
unnamed: J2.3, RV1.3
unnamed: J5.1, K1.10
unnamed: K1.1, R3.1
unnamed: K1.2, U2.5 (VO)
unnamed: Q1.1 (G), U1.5 (VO)
unnamed: R1.1, U1.1
unnamed: R2.1, U2.1
unnamed: R3.2, TP2.1, U3.4 (+VOUT)

Notes on the sheet:
[Kicker Part]
[Dribbler Part]

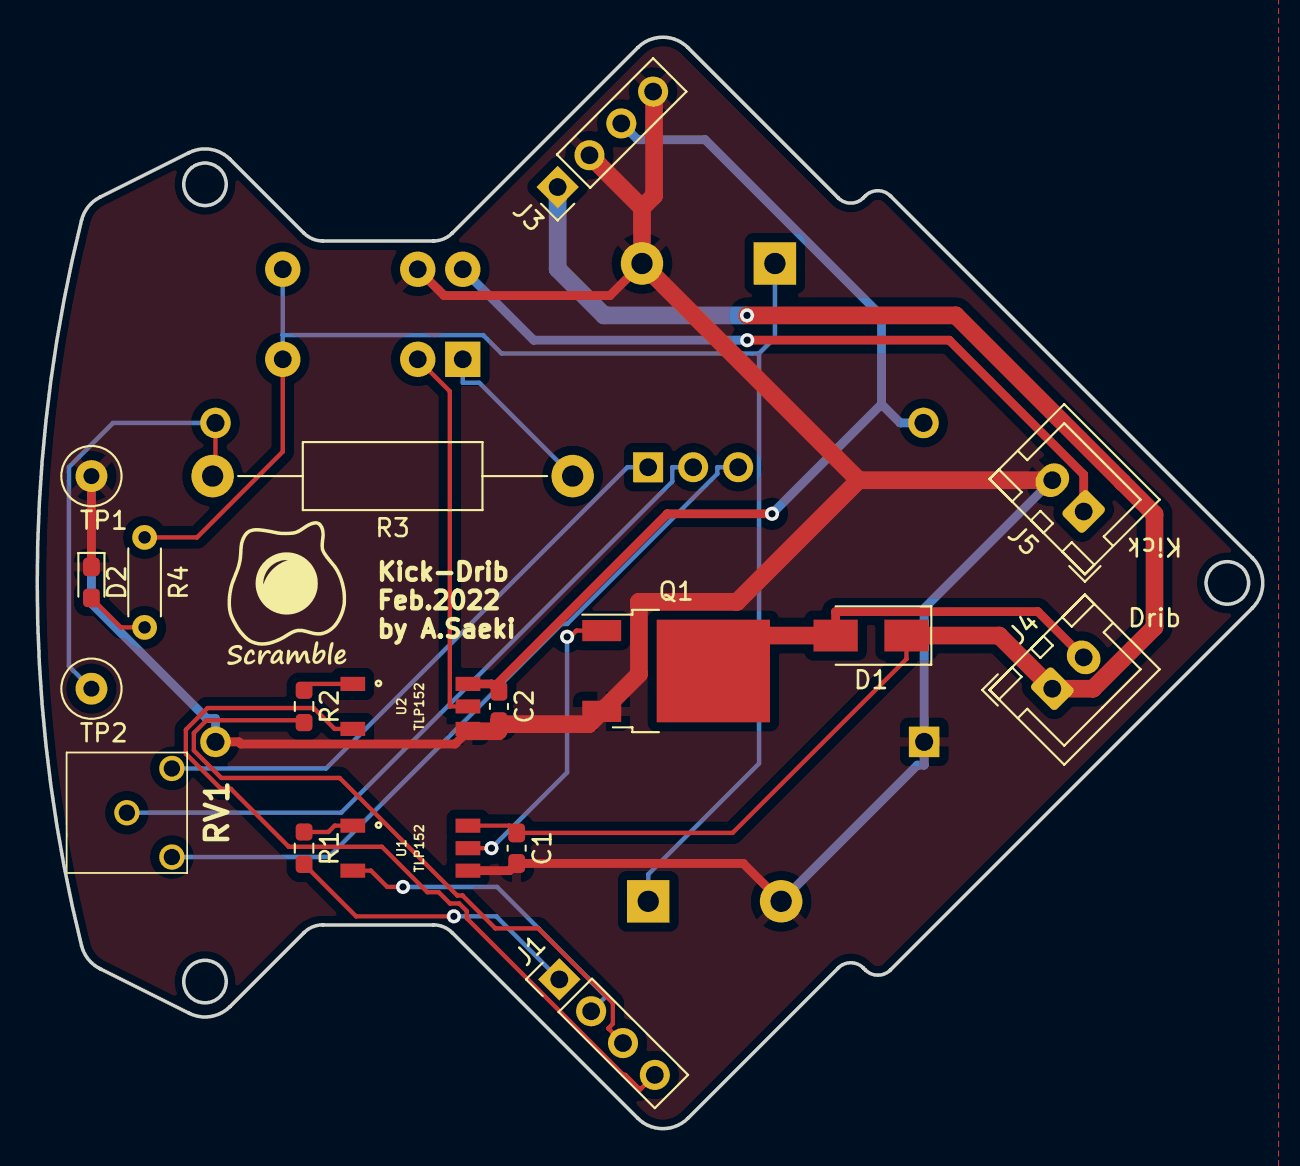
[picture p23: board kick-drib-2.kicad_pcb from above]

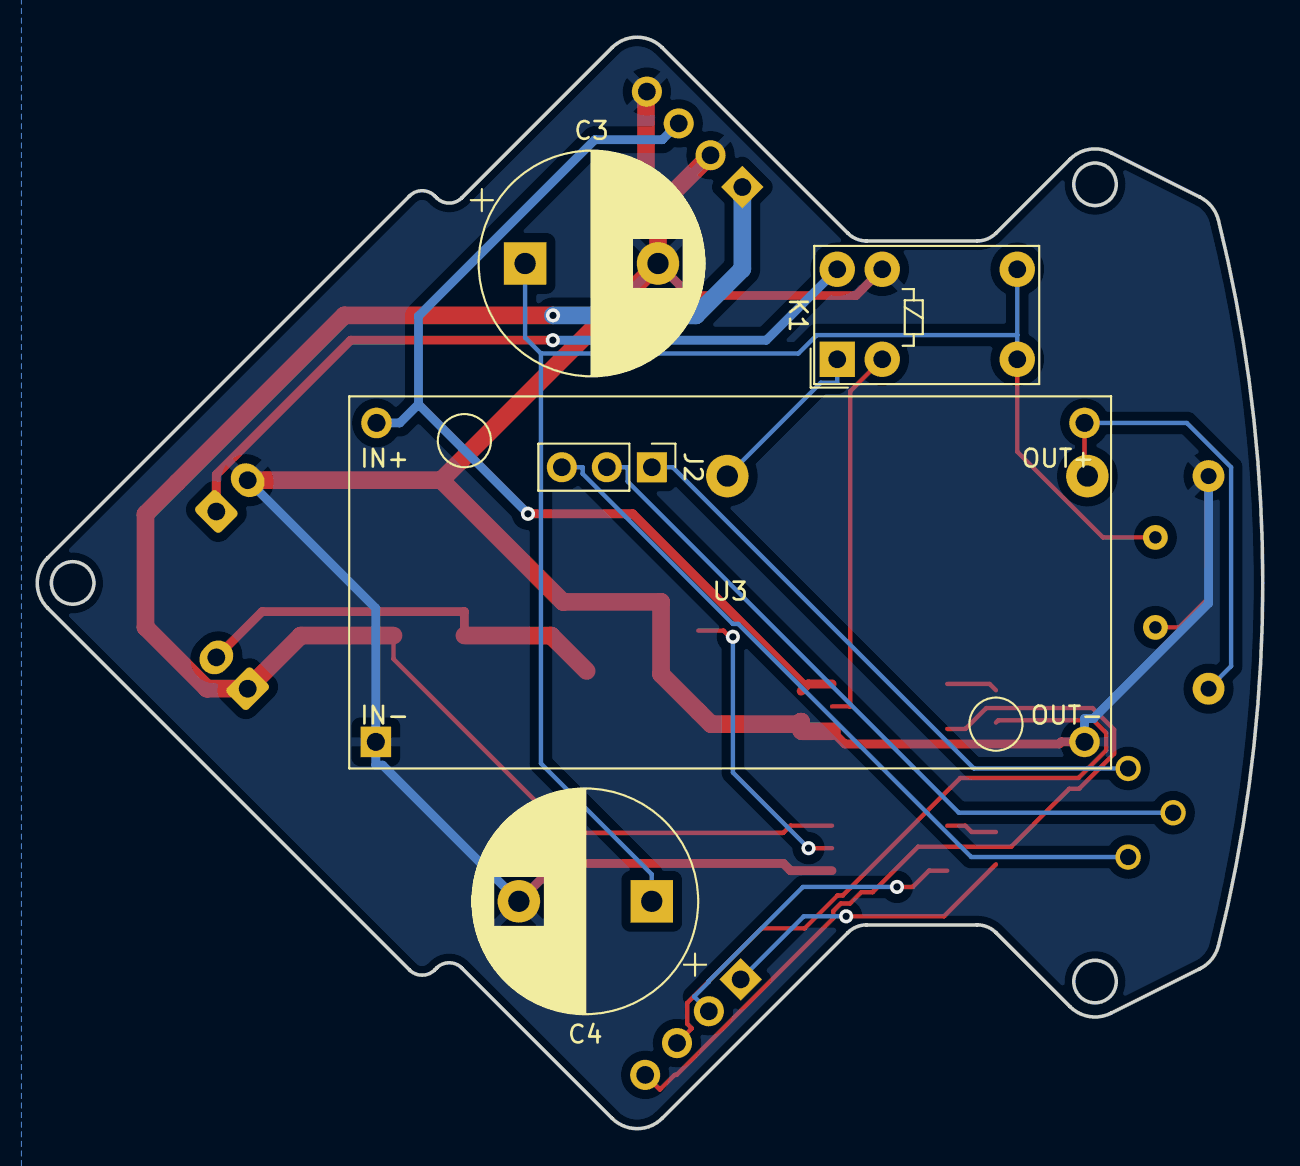
[picture p24: board kick-drib-2.kicad_pcb from below]

Board: 2 copper layers, 69.2 x 61.6 mm, 23 parts (5 on the bottom side), 20 nets.
