scramble-robot/rcj-2022/kicad/IMU_BNO055_20210802/IMU_BNO055_20210802.kicad_pcb

## KiCad design kicad/IMU_BNO055_20210802/IMU_BNO055_20210802.kicad_pcb (2022-02-06)

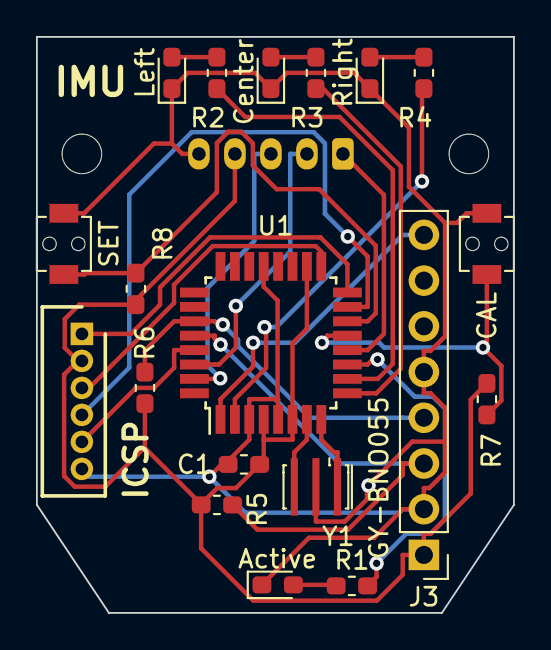
[picture p25: board IMU_BNO055_20210802.kicad_pcb from above]

Board: 2 copper layers, 26.5 x 32.0 mm, 22 parts (1 on the bottom side), 24 nets.

Parts:
C1: 0.1u; C_0603_1608Metric_Pad1.05x0.95mm_HandSolder
D2: Active; LED_0603_1608Metric_Pad1.05x0.95mm_HandSolder
D3: Left; LED_0603_1608Metric_Pad1.05x0.95mm_HandSolder
D4: Center; LED_0603_1608Metric_Pad1.05x0.95mm_HandSolder
D5: Right; LED_0603_1608Metric_Pad1.05x0.95mm_HandSolder
J1: ICSP; JSTB6B-ZR
J2: SerialOUT; JST_PH_S5B-PH-K_1x05_P2.00mm_Horizontal
J3: GY-BNO055; PinHeader_1x08_P2.54mm_Vertical
R1, R2, R3, R4: 120; R_0603_1608Metric_Pad1.05x0.95mm_HandSolder
R5, R6, R7, R8: 10k; R_0603_1608Metric_Pad1.05x0.95mm_HandSolder
REF01, REF02: MountingHole_2.2mm_M2
SW1: CAL; TVAF06-A020B-R
SW2: SET; TVAF06-A020B-R
U1: ATmega328P-AU; TQFP-32_7x7mm_P0.8mm
Y1: X`Tal 16MHz; Resonator_SMD_muRata_CSTxExxV-3Pin_3.0x1.1mm_HandSoldering

Connections:
+5V: C1.1, J1.2, J2.4, J3.1, R5.1, R6.1, R7.1, R8.1, U1.4, U1.6, U1.18
GND: C1.2, D2.1, D3.1, D4.1, D5.1, J1.6, J2.5, J3.2, J3.5, SW1.2, SW2.2, U1.3, U1.5, U1.21, Y1.2
unnamed: D2.2, R1.1
unnamed: D3.2, R2.1
unnamed: D4.2, R3.1
unnamed: D5.2, R4.1
unnamed: J1.1, U1.16
unnamed: J1.3, U1.17
unnamed: J1.4, U1.15
unnamed: J1.5, U1.29
unnamed: J2.1, U1.12
unnamed: J2.2, U1.30
unnamed: J2.3, U1.31
unnamed: J3.3, R5.2, U1.28
unnamed: J3.4, R6.2, U1.27
unnamed: J3.8, U1.1
unnamed: R1.2, U1.11
unnamed: R2.2, U1.10
unnamed: R3.2, U1.9
unnamed: R4.2, U1.2
unnamed: R7.2, SW1.1, U1.13
unnamed: R8.2, SW2.1, U1.14
unnamed: U1.7, Y1.3
unnamed: U1.8, Y1.1
