scramble-robot/rcj-2022/Vison-raspi/cam-test/cam_docking-+ai.py

#!/usr/bin/env python
# -*- coding: utf-8 -*-
"""
[summary]
cam remapping test
[description]
"""
"""
GUIDE

np.average (numpy)
https://deepage.net/features/numpy-average.html

cv.VideoCapture() 
https://note.nkmk.me/python-opencv-videocapture-file-camera/

https://pystyle.info/opencv-resize/

数学タイムはこれの5.2のとこ
https://www.slideshare.net/AkitoshiSaeki/2020-245976441
"""
#目標

#前回 320x240*(30-40)FPS
#今回 640x480*(30-40)FPS
"""
n*C回検知
n分割 C層
連続する角度が一番広い角度を使用

"""

#from __future__ import (division, absolute_import, print_function, unicode_literals)

import cv2 as cv

import argparse
import copy

import math
import numpy as np
import random

import time

from classes import WBsRGB as wb_srgb  # ホワイトバランスライブラリ

#import serial


# ホワイトバランス（動画の切り抜きのL*A*B*値を調整）
def white_balance_loops(img, h, w):

    #result = cv.cvtColor(img, cv.COLOR_BGR2LAB)  # 画像をBGR->L*A*B*に変換  result[ 画像x座標, 画像y座標, 0=L_1=a_2=b]

    #avg_a = int(256*np.average(result[:, :, 1]))-32768  # 画像全体のA*B*値の平均を取得　avg_a,avg_b=double
    #avg_b = int(256*np.average(result[:, :, 2]))-32768  # 32768=128*256

    #for i in range(h):  # 各ピクセルでL*A*B*値を調整(ホワイトバランス)
    #    for j in range(w):
    #        l, a, b = result[i, j, :]  # 座標(x,y)のL*A*B*値を変数にいれる  l,a,b=int?
    #        l *= 35  # 調整  35.2=1.1/256*(2**13)
    #        result[i, j, 1] = ((a<<21) - (avg_a * l))>>21
    #        result[i, j, 2] = ((b<<21) - (avg_b * l))>>21

    #result = cv.cvtColor(result, cv.COLOR_LAB2BGR)  # ホワイトバランスしたresult[]をL*A*B*->BGRに変換

    #return result

    upgraded_model = 0
    gamut_mapping = 2

    wbModel = wb_srgb.WBsRGB(gamut_mapping=gamut_mapping,
                             upgraded=upgraded_model)
    result = wbModel.correctImage(img)  # white balance it

    return result
    # https://github.com/mahmoudnafifi/WB_sRGB/blob/master/WB_sRGB_Python/demo.py#L49


# 赤色検知
def red_detect(img):
    # HSV色空間に変換
    hsv = cv.cvtColor(img, cv.COLOR_BGR2HSV)

    # 赤色のHSVの値域1
    hsv_min = np.array([0, 127, 0])
    hsv_max = np.array([30, 255, 255])
    mask1 = cv.inRange(hsv, hsv_min, hsv_max)

    # 赤色のHSVの値域2
    hsv_min = np.array([150, 127, 0])
    hsv_max = np.array([179, 255, 255])
    mask2 = cv.inRange(hsv, hsv_min, hsv_max)

    return mask1 + mask2


# ブロブ解析
def analysis_blob(binary_img):
    # 2値画像のラベリング処理
    label = cv.connectedComponentsWithStats(binary_img)

    # ブロブ情報を項目別に抽出
    n = label[0] - 1
    data = np.delete(label[2], 0, 0)
    center = np.delete(label[3], 0, 0)

    # 面積最大ブロブの情報格納用
    maxblob = {}

    data = np.append(data, np.array([[0, 0, 0, 0, 0]]), axis=0)
    # ブロブ面積最大のインデックス
    max_index = np.argmax(data[:, 4])

    #data[:,4]=0の時は見つからなかったとき
    if data[:, 4][max_index]:
        # 面積最大ブロブの各種情報を取得
        maxblob["upper_left"] = (data[:, 0][max_index], data[:, 1][max_index]
                                 )  # 左上座標
        maxblob["width"] = data[:, 2][max_index]  # 幅
        maxblob["height"] = data[:, 3][max_index]  # 高さ
        maxblob["area"] = data[:, 4][max_index]  # 面積
        maxblob["center"] = center[max_index]  # 中心座標
        maxblob["found"] = True  #見つかったかどうか
    else:
        maxblob["found"] = False

    return maxblob


#メイン
def main():
    print('LOADING...')

    # ホワイトバランス用の画像読み込み
    #img = cv.imread('image')

    # 動画の読み込み(バグったらVideo I/Oの確認) cap=<class 'cv2.VideoCapture'>
    #cap = cv.VideoCapture(r'D:\Creation\RCJ\guto_code\1.mp4')
    cap = cv.VideoCapture(0)
    #cap = final

    # 縦横の長さの変更
    Height = 640
    Width = 480

    print('HEIGHT', end='---')
    print(cap.set(cv.CAP_PROP_FRAME_HEIGHT, Height))
    print('WIDTH ', end='---')
    print(cap.set(cv.CAP_PROP_FRAME_WIDTH, Width))
    print('FPS', end='---')
    print(cap.get(cv.CAP_PROP_FPS))

    # カメラの個体値(お触り禁止)
    b = 42.7
    b2 = pow(b, 2)
    c = 59.9
    c2 = pow(c, 2)
    d = 13.125
    Z = 182.5
    f = -3.04  #[mm]   # * 0.001  #[m]
    f2 = pow(f, 2)
    H = 200

    #FPS計測器
    count = 0
    start_time = 0

    #フレーム用意
    ret, frame = cap.read(
    )  #フレームの読み込み&次のフレームに移行 ret=bool(読み込めたか),frame=<class 'numpy.ndarray'>
    if not ret:  #読み込み失敗orフレームの終わりの時
        print('cap.read() error')

    #下準備
    h, w = frame.shape[:2]  #height,widthをh,wにいれる
    map_x = np.zeros(
        (h, w),
        dtype=np.float32)  #h*w次元配列を作る map_x,map_y=<class 'numpy.ndarray'>
    map_y = np.zeros((h, w), dtype=np.float32)

    #数学タイム用
    Hh = int(h / 2)
    Hw = int(w / 2)
    sc = 5

    #map_x,map_yを作ろう
    for i in range(h):  #Y座標
        for j in range(w):  #X座標

            x = (j - Hw)  #原点を左上から中心に移動
            y = (i - Hh)

            if x == 0:  #0除算回避
                x = 0.0001

            #数学タイム
            rp = math.sqrt(pow(x, 2) + pow(y, 2))  #原点からの距離？
            Rp = (-(b2 - c2) * H * rp) / (
                (b2 + c2) * f -
                2 * b * c * math.sqrt(math.sqrt(pow(rp, 2) + f2)))
            X = Rp / (math.sqrt(1 + (pow(y, 2) / pow(x, 2)))) / sc
            Y = (y / x) * X

            if j > Hw:
                map_x[i, j] = Hw - X
                map_y[i, j] = Hh - Y
            else:
                map_x[i, j] = Hw + X
                map_y[i, j] = Hh + Y

    # カラートラッキングに使うやつ

    R_num = 2  # 円の数
    R_array = np.array([100, 200])  #それぞれの円の半径
    Sep_num = 180  # 円を分ける数

    xT = np.zeros((Sep_num, R_num), dtype=np.int16)  #テーブル作り
    yT = np.zeros((Sep_num, R_num), dtype=np.int16)
    for i in range(Sep_num):
        for j in range(R_num):
            xT[i, j] = Hw + R_array[j] * math.sin(2 * math.pi * i / Sep_num)
            yT[i, j] = Hh - R_array[j] * math.cos(2 * math.pi * i / Sep_num)

    #閾値
    lower_yellow = np.array([0, 100, 125])
    upper_yellow = np.array([179, 235, 180])

    #どね！
    print('DONE!')

    #各フレームで実行するためのWhileループ -----------------------------------------------
    while True:

        #時間計測
        count = count + 1
        if time.perf_counter() - start_time > 1.0:
            print('FPS= ', end='')
            print(count)
            count = 0
            start_time = time.perf_counter()

        #フレーム用意
        ret, frame = cap.read(
        )  #フレームの読み込み&次のフレームに移行 ret=bool(読み込めたか),frame=<class 'numpy.ndarray'>
        if not ret:  #読み込み失敗orフレームの終わりの時
            print('cap.read() error')
            break

        #ホワイトバランス
        frame = white_balance_loops(frame, h, w)
        frame = cv.remap(frame, map_x, map_y, cv.INTER_LINEAR)

        #新カラートラッキング
        search = np.zeros((Sep_num), dtype=np.bool_)  # 見つかったらTrue
        S_Count = 0  #カウント用
        S_maxCount = 0  # 現在最大カウント
        S_maxPos = -1  # 現在最大の場所(ゴールになりそうな場所)
        #ゴールの位置探し
        for i in range(Sep_num):
            for j in range(R_num):  #位置探し
                if (lower_yellow[0] <= frame[yT[i, j], xT[i, j], 0]
                        and frame[yT[i, j], xT[i, j], 0] <= upper_yellow[0]
                        and lower_yellow[1] <= frame[yT[i, j], xT[i, j], 1]
                        and frame[yT[i, j], xT[i, j], 1] <= upper_yellow[1]
                        and lower_yellow[2] <= frame[yT[i, j], xT[i, j], 2]
                        and frame[yT[i, j], xT[i, j], 2] <= upper_yellow[2]):
                    search[i] = True
            if search[i]:
                S_Count = S_Count + 1  # カウント
            else:
                if S_maxCount < S_Count:  # 最大値更新
                    S_maxCount = S_Count
                    S_maxPos = i - 1
                S_Count = 0
        if S_maxCount < S_Count:  # 最大値更新(端っこにあった時用)
            S_maxCount = S_Count
            S_maxPos = Sep_num

        #ゴールの中央をみつけよう！！！！！

        #旧カラートラッキング
        # 赤色検出
        mask = red_detect(frame)

        # マスク画像をブロブ解析（面積最大のブロブ情報を取得）
        target = analysis_blob(mask)

        if target["found"]:
            # 面積最大ブロブの中心座標を取得
            center_x = int(target["center"][0])
            center_y = int(target["center"][1])

            # フレームに面積最大ブロブの中心周囲を円で描く
            cv.circle(frame, (center_x, center_y),
                      30, (0, 200, 0),
                      thickness=3,
                      lineType=cv.LINE_AA)
        # 画像全体に円表示
        #cv.circle(frame,(Hw,Hh),h/3,(255,255,0),thickness=1, lineType=cv.LINE_AA)
        #cv.circle(frame,(Hw,Hh),,(255,255,0),thickness=1, lineType=cv.LINE_AA)

        #デバッグ用の円
        for i in range(Sep_num):
            if search[i]:
                if S_maxPos - S_maxCount + 1 <= i and i <= S_maxPos:
                    for j in range(R_num):
                        cv.circle(frame, (xT[i, j], yT[i, j]),
                                  0, (0, 0, 255),
                                  thickness=2,
                                  lineType=cv.LINE_AA)
                else:
                    for j in range(R_num):
                        cv.circle(frame, (xT[i, j], yT[i, j]),
                                  0, (255, 255, 0),
                                  thickness=2,
                                  lineType=cv.LINE_AA)

        cv.line(frame, (Hw, Hh), (xT[0, 1], yT[0, 1]), (0, 255, 255),
                thickness=1,
                lineType=cv.LINE_AA)

        #表示
        cv.imshow('output', frame)

        #緊急脱出
        key = cv.waitKey(1)
        if key == 27:  # ESC
            break

    cap.release()  #動画を閉じる
    cv.destroyAllWindows()  #ウィンドウ全削除


#本体
if __name__ == '__main__':
    main()
