scramble-robot/rcj-2022/(commit log)

2022-02-02 最初の第一歩
2022-02-02 京滋奈まで
2022-02-02 階層変更
2022-02-07 あわせたやつ
2022-02-26 自作途中
